ravotus/FaucetLED/README.md

# Faucet LED #
This project has a simple goal: To add a LED to a faucet which changes with temperature.

For the associated PCB, see [https://github.com/ravotus/FaucetLED-pcb](https://github.com/ravotus/FaucetLED-pcb)
