ravotus/FaucetLED/hardware/hardware.txt

LEDs
====
If 3.2V is not right enough on Green/Blue, could either remove series resistors, or go to up to 3.4 or 3.5V supply for micro (3.6V is max)

assume 3.3V supply:
Red: needs >=70 ohm (use 47+33=80)
Green/Blue: Needs >=5 ohm (10ohm in || )

From testing:
Rred = 78ohm (10+68), Ired = 18.49mA (78.7 is a standard value)
Rgreen = 10ohm, Igreen = 19.70mA
Rblue = 22ohm, Iblue = 19.64mA

Rred = 78ohm (10+68), Ired = 18.49mA
Rgreen = 12.2ohm (15||68), Igreen = 18.28mA
Rblue = 25ohm (15+10), Iblue = 18.60mA

Pin notes
=========
If you want to use a WKUP pin, must use WKUP4. In that case, cannot use LPUART.
On Nucleo board, VCP is connected to PA2 and PA15 (USART2).
If you want to power directly from 3.3V, need to remove some SB's

Clocks
======
MSI is much more power friendly than HSI48, also starts up faster (190uA vs 380uA) - although stabilization time is longer
HSI16 is very similar to MSI for current - both 190uA. Stabilization is much better though.

ADC
===
Be sure to calibrate ADC on powerup. Software can save the calibration value and restore it each time.
Is being very picky - seems to always be one conversion short in interrupt or polling mode, unless I slow the ADC way down (/128 clk).
Per datasheet, Vrefint needs a sampele time of 4us minimum.
If using oversampling on both regular and injected channels, the oversampling ratio must be the same! (or reconfigured before starting each conversion)

Piezo amplifier circuit
=======================
Bias at Vcc/2 to avoid issues with differential signal.
Need to drive into ~10kohm load
Supply current to TLV2772: ~1.5mA
Current to MAX4257: ~1.0mA

Choose MAX4256 (has SHDN input)

Temperature sensor
==================
Configure UART Tx/Rx pin as Open-Drain, with no internal pull up/down. The internal pullup is not strong enough.
Use an external 4.7kohm pullup.

CRC:
Both input and output needs to be configured to reverse bits, byte-wise. Use Dallas 1-wire CRC polynomial 0x31.

Power input
===========
Removed SB9 from Nucleo board and replaced with jumper. With jumper off, can power Nucleo from 5VIN but with any voltage
less than 5.5V. Micro ran fine even down to 2.5V, but below about 2.7V the blue LED didn't work (as expected). VIN is not
a feasible option due to the high dropout of the 5V regulator on that input. And obviously the 3.3V input is not an option
without an external regulator.

Low-power mode
==============
FreeRTOS running normally: 15mA
FreeRTOS tickless idle: 4.57mA
FreeRTOS tickless idle in LP sleep 10ms task MSI clk 400kHz: 707.95uA
To check for regressions with low-power tickless idle:
1. Configure one task to run every 10ms.
2. In PreSleepProcessing() inside freertos.c, set a GPIO right before calling HAL_PWR_EnterSLEEPMode, and clear it afterwards.
3. You should see the GPIO high (sleeping) approximately 80% of the time, and the signal having a period of around 10ms.
   You should not see the signal go high and low immediately, which indicates that the micro woke up instantly.
