ravotus/FaucetLED/resources/The Principles of Piezoelectric Accelerometers _ Sensors.pdf

12/10/2016 | The Principles of Piezoelectric Accelerometers | Sensors
file:///C:/Projects/FaucetLED/resources/The%20Principles%20of%20Piezoelectric%20Accelerometers%20_%20Sensors.html | 1/8

# Acceleration/Vibration

## Most Read Articles

Home (http://www.sensorsmag.com/?sessionGUID=0908801d-67c7-ac48-233a-68e95b3e403c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) > Sensors Products (http://www.sensorsmag.com/category/sensor/sensors-products?sessionGUID=0908801d-67c7-ac48-233a-68e95b3e403c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) > Acceleration/Vibration (http://www.sensorsmag.com/category/sensor/sensors-products/accelerationvibration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)
Related topics: Acceleration/Vibration, (http://www.sensorsmag.com/category/sensor/sensors-products/accelerationvibration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)Sensors Mag, (http://www.sensorsmag.com/category/sensor/sensors-mag?sessionGUID=0908801d-67c7-ac48-233a-68e95b3e403c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) Technologies in Depth, (http://www.sensorsmag.com/category/magazine-catchall/technologies-depth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) Technology Tutorials (http://www.sensorsmag.com/category/magazine-catchall/technology-tutorials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)

# The Principles of Piezoelectric Accelerometers

February 1, 2004
By: Guy Kulwanoski, (http://www.sensorsmag.com/sensors-author/guy-kulwanoski?sessionGUID=0908801d-67c7-ac48-233a-68e95b3e403c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) Kistler Instrument Corp., Jeff Schnellinger, (http://www.sensorsmag.com/sensors-author/jeff-schnellinger?sessionGUID=0908801d-67c7-ac48-233a-68e95b3e403c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) Kistler Instrument Corp.
Like 24 people like this.

The piezoelectric effect, discovered in 1880 by Pierre and Jacques Curie, remained a mere curiosity until the 1940s. The property of certain crystals to exhibit electrical charges under mechanical loading was of no practical use until very high input impedance amplifiers enabled engineers to amplify the signals produced by these crystals. In the 1950s, electrometer tubes of sufficient quality became available and the piezoelectric effect was commercialized.

Most piezoelectric accelerometers are made of quartz crystal, piezoelectric ceramics, or, for hightemperature operation, tourmaline or lithium niobate. They obey Newton's second law, F = ma, in that the force acting on the measuring element is directly proportional to the acceleration produced. Available in a wide range of configurations and operating specifications, these devices are used wherever shock or vibration is of interest.

The charge amplifier principle was patented by W.P. Kistler in 1950 and gained practical significance in the 1960s. The introduction of MOSFET solidstate circuitry and the development of highly insulating materials such as Teflon and Kapton greatly improved performance and propelled the use of piezoelectric sensors into virtually all areas of modern technology and industry.

Email Newsletters (http://www.sensorsmag.com/sensors-newsletter-subscription?sessionGUID=0908801d-67c7-ac48-233a-68e95b3e403c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)

White Paper Library (http://www.sensorsmag.com/white-paper-library?sessionGUID=0908801d-67c7-ac48-233a-68e95b3e403c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)

Sensors Job Board (http://jobs.sensorsmag.com/)

A Dozen Ways to Measure Fluid Level and How They Work (http://www.sensorsmag.com/sensors/leak-level/a-dozen-ways-measure-fluid-level-and-how-they-work-1067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)

Fundamentals of Pressure Sensor Technology (http://www.sensorsmag.com/sensors/pressure/fundamentals-pressure-sensor-technology-846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)

Manometer Basics (http://www.sensorsmag.com/sensors/pressure/manometer-basics-1073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)

The Basics of Rotameters (http://www.sensorsmag.com/sensors/flow/the-basics-rotameters-1068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)

The Principles of Level
Measurement (http://www.sensorsmag.com/sensors/leak-level/the-principles-level-measurement-941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)

## Editor’s Picks

ARTICLE
A Testbed for Building Intuitive and Scalable IoT Apps (http://www.sensorsmag.com/internet-things/testbed-building-intuitive-and-scalable-iot-apps-24087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)

NEWS
High Pressure Seals Market Worth 6.99 Billion USD by
2026 (http://www.sensorsmag.com/news/market-news/news/high-pressure-seals-market-worth-699-billion-usd-2026-24095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)

NEWS
Smart Material Market
Estimated to Generate $72.63 Billion by 2022 (http://www.sensorsmag.com/news/market-news/news/smart-material-market-estimated-generate-7263-billion-2022-24096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)

NEWS
Service Robotics Market Worth (http://www.sensorsmag.com/news/market-news/news/service-robotics-market-worth-us-13-billion-2021-24075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)
Electronics & Computers (http://www.sensorsmag.com/electronics-computers?sessionGUID=0908801d-67c7-ac48-233a-68e95b3e403c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) | Embedded Systems (http://www.sensorsmag.com/electronics-computers/embedded-systems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) | Internet of Things (http://www.sensorsmag.com/networking-communications/internet-of-things-0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) | Machine Manufacturing (http://www.sensorsmag.com/machine-manufacturing?sessionGUID=0908801d-67c7-ac48-233a-68e95b3e403c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) | Process Industries (http://www.sensorsmag.com/process-industries?sessionGUID=0908801d-67c7-ac48-233a-68e95b3e403c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) | Specialty Markets (http://www.sensorsmag.com/specialty-markets?sessionGUID=0908801d-67c7-ac48-233a-68e95b3e403c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) | Wireless & M2M (http://www.sensorsmag.com/networking-communications?sessionGUID=0908801d-67c7-ac48-233a-68e95b3e403c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)
Home (http://www.sensorsmag.com/?sessionGUID=0908801d-67c7-ac48-233a-68e95b3e403c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) | News (http://www.sensorsmag.com/listing/94/news-room?sessionGUID=0908801d-67c7-ac48-233a-68e95b3e403c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) | Resource Center (http://www.sensorsmag.com/?sessionGUID=0908801d-67c7-ac48-233a-68e95b3e403c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) | Technical Articles (http://www.sensorsmag.com/technical-articles?sessionGUID=0908801d-67c7-ac48-233a-68e95b3e403c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) | About Sensors (http://www.sensorsmag.com/about-sensors?sessionGUID=0908801d-67c7-ac48-233a-68e95b3e403c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) | Advertise (http://www.sensorsmag.com/advertise?sessionGUID=0908801d-67c7-ac48-233a-68e95b3e403c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) | Browse by Topic (http://www.sensorsmag.com/browse-by-topic?sessionGUID=0908801d-67c7-ac48-233a-68e95b3e403c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) | Sensors Expo (http://www.sensorsmag.com/sensorsexpo?sessionGUID=0908801d-67c7-ac48-233a-68e95b3e403c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)

file:///C:/Projects/FaucetLED/resources/The%20Principles%20of%20Piezoelectric%20Accelerometers%20_%20Sensors.html | 2/8

Figure 1. Piezoelectric crystals that are cut so that they exhibit the longitudinal effect (A) are sensitive to compression forces. They are used primarily to measure force, pressure, strain, and acceleration. The transverse effect (B) makes it possible to obtain a greater charge by suitable shaping and arrangement of the piezoelectric elements, and is used primarily in pressure sensors. Shear effect elements
(C) are chiefly used in accelerometers and 3-component force sensors. They have low basestrain sensitivity (the amount of strains in an object under test that are transmitted via the base plate to the sensor element) and a (https://www.facebook.com/SensorsMagazine) wellb (https://twitter.com/sensorsonline)ehav (http://www.linkedin.com/groups/Sensors-Magazine-4568519?trk=myg_ugrp_ovr)ed (http://www.sensorsmag.com/rss-subscription?sessionGUID=0908801d-67c7-ac48-233a-68e95b3e403c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) response to rapid temperatu (https://www.facebook.com/SensorsMagazine)re c (https://twitter.com/sensorsonline)hang (http://www.linkedin.com/groups/Sensors-Magazine-4568519?trk=myg_ugrp_ovr)es (http://www.sensorsmag.com/rss-subscription?sessionGUID=0908801d-67c7-ac48-233a-68e95b3e403c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) because these influences act in a direction perpendicular to the sensitive shear axis.

Piezoelectric measuring systems are active electrical systems. That is, the crystals produce an electrical output only when they experience a change in load?they cannot perform true static measurements. However, it is a misconception that piezoelectric iýstruments are suitable for only dynamic measurements. Quartz transducers, when paired with adequate signal conditioners, offer excellent quasistatic measuring capability. There are countless examples of applications where quartzbased sensors accurately and reliably measure quasistatic phenomena for minutes and even hours.

There are two types of piezoelectric sensor: high and low impedance. Highimpedance units have a charge output that requires a charge amplifier or external impedance converter for chargetovoltage conversion. Lowimpedance types use the same piezoelectric sensing element as highimpedance units and also incorporate a miniaturized builtin chargetovoltage converter. They also require an external power supply coupler to energize the electronics and decouple the subsequent DC bias voltage from the output signal.

Quartz-Based Piezoelectric Sensors

Although this article focuses on accelerometers, the response function for force and pressure sensors is nearly identical. In fact,

many force applications are closely related to acceleration. On the other
hand, pressure sensors are designed to minimize or eliminate (by direct
compensation of the charge output) the vibration effect.

Quartz piezoelectric sensors consist essentially of thin slabs or plates cut in a precise orientation to the crystal axes depending on the application (see Figure 1, and "The Piezoelectric Effect in Crystals"). (http://www.sensorsmag.com/sensors/acceleration-vibration/the-principles-piezoelectric-accelerometers-1022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) Most Kistler sensors incorporate a quartz element that is sensitive to either compressive or shear loads. The shear cut is used for multicomponent force and acceleration measuring sensors. Other specialized cuts include the transverse cut for some pressure sensors and the polystable cut for hightemperature pressure sensors.

The finely lapped quartz elements are assembled either singly or in stacks and preloaded in some manner. The quartz package generates a charge signal, measured in picoCoulombs, that is directly proportional to the sustained force. Each sensor type uses a quartz configuration optimized and ultimately calibrated for its particular application (e.g., force, pressure, acceleration, or strain).

Of the large number of piezoelectric materials available today, quartz is preferred in sensor designs because of the following properties:

Material stress limit of ~20,000 psi
Temperature resistance up to 930°F
Very high rigidity, high linearity, and negligible hysteresis Almost constant sensitivity over a wide temperature range Ultrahigh insulation resistance (1014 ), allowing lowfrequency measurements (<1 Hz)

Dynamic Behavior

Piezoelectric sensors for measuring pressure, force, and acceleration may
be regarded as underdamped, spring mass systems with a single degree
of freedom. They are modeled by the classical secondorder differential equation whose solution is:

(1)

where:
fn = undamped natural (resonant) frequency (Hz)
f = frequency at any given point of the curve (Hz) ao = output acceleration
ab = mounting base or reference acceleration (f/fn = 1)
Q = factor of amplitude increase at resonance

Quartz sensors have a Q of ~10?40; the phase angle can therefore be written as:

(2)

US$ 13 Billion by 2021 (http://www.sensorsmag.com/news/market-news/news/service-robotics-market-worth-us-13-billion-2021-24075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)

NEWS
Color Microscope Camera
Provides Intelligent Real-Time and Fluorescence Imaging (http://www.sensorsmag.com/sensors-products/machine-vision/news/color-microscope-camera-provides-intelligent-real-time-and-24081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)
Log in (https://googleads.g.doubleclick.net/pcs/click?sig=Cg0ArKJSzJTVI3IMU-1c) | Sea | Print | Email rch

file:///C:/Projects/FaucetLED/resources/The%20Principles%20of%20Piezoelectric%20Accelerometers%20_%20Sensors.html | 3/8

As can be seen in a typical frequency response curve (see Figure 2), an amplitude rise of ~5% can be expected at ~

1
/5 of fn

Figure 2. In this typical response curve, 1 = lowfrequency limit determined by RC rolloff characteristics; 2 = usable range; 3 = highpass filter; and 4 = with lowpass filter, which can be used to attenuate the effects of the amplitude rise at ~1/5 the resonance frequency.

Lowpass filtering can be used to attenuate the effects of this. Many Kistler signal conditioners (charge amplifiers and couplers) have plugin filters for this purpose.

Charge Amplifiers

Basically the charge amplifier consists of a highgain inverting voltage amplifier with a MOSFET or JFET at its input to achieve high insulation resistance (see Figure 3).

Figure 3. The charge amplifier consists of a highgain inverting voltage amplifier with a FET at its input for high insulation resistance. In this simplified schematic, 1 = accelerometer; 2 = charge amplifier; Vo = output voltage; A = openloop gain; Ct = sensor capacitance; Cc = cable capacitance; Cr = range (or feedback) capacitor; Rt = time constant resistor (or insulation resistance of range capacitor); Ri = insulation resistance of input circuit (cable and sensor); and q = charge generated by sensor.

The effects of Rt and Ri will be discussed below. Neglecting their effects, the resulting output voltage, Vo

, becomes:

(3)

where:

Log in (http://www.sensorsmag.com/sensors-magazine-media-kit-request?sessionGUID=0908801d-67c7-ac48-233a-68e95b3e403c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) | Sea | Print | Email rch

file:///C:/Projects/FaucetLED/resources/The%20Principles%20of%20Piezoelectric%20Accelerometers%20_%20Sensors.html | 4/8

q = charge generated by the sensor Cr = range capacitor
Ct = sensor capacitance
Cc = cable capacitance
A = openloop gain

For sufficiently high openloop gain, the cable and sensor capacitance can be neglected, leaving the output voltage dependent only on the input charge and the range capacitance:

(4)

In short, the amplifier acts as a charge integrator that compensates the sensor's electrical charge with a charge of equal magnitude and opposite polarity, and ultimately produces a voltage across the range capacitor. In effect, the purpose of the charge amplifier is to convert the high impedance charge input, q, into a usable output voltage, Vo

Time Constant and Drift. Two of the more important considerations in the practical use of charge amplifiers are time constant and drift. The time constant (TC) is defined as the discharge time of an AC-coupled circuit. In a period of time equivalent to one time constant, a step input will decay to 37% of its original value. The TC of a charge amplifier is determined by the product of the range capacitor, Cr

, and the time constant resistor, Rt

:

(5)

Drift is defined as an undesirable change in output signal over time that is not a function of the measured variable. Drift in a charge amplifier can be caused by low insulation resistance at the input, Ri

, or by leakage current of the input MOSFET or JFET. Drift and time constant simultaneously affect a charge amplifier's output. One or the other will be dominant. Either the charge amplifier output will drift toward saturation (power supply) at the drift rate, or it will decay toward zero at the time constant rate.

Many Kistler charge amplifiers have selectable time constants that are altered by changing the time constant resistor Rt

. Several
of these charge amplifiers have a short, medium, or long time constant selection switch. In the long position, drift dominates any time constant effect. As long as the input insulation resistance Ri

is maintained at >10

13
, the charge amplifier (with MOSFET input) will drift at an approximate rate of 0.03 pC/s. Charge amplifiers with JFET inputs are available for industrial applications but have an increased drift rate of ~0.3 pC/s. In the short and medium positions, t°e time constant effect dominates normal leakage drift. The actual value can be determined by referring to the appropriate operation/instruction manual supplied with the unit.

Frequency and Time Domain Considerations. When considering the effects of time constant, the user must think in terms of either frequency or time domain. The longer the time constant, the better the lowend frequency response and the longer the usable measuring time. When measuring vibration, time constant has the same effect as a singlepole, highpass filter whose amplitude and phase are:

(6)

(7)

For example, the output voltage has declined ~5% when f × (TC) = 0.5 and the phase lead = 18°. When measuring events with wide (or multiple) pulse widths, the time constant should be at least 100 × longer than the total event duration. Otherwise, the DC component of the output signal will decay toward zero before the event is completed.

Other design features incorporated into Kistler charge amplifiers include range normalization for whole number output, lowpass filters for attenuating sensor resonant effects, electrical isolation for minimizing ground loops, and digital/computer control of setup parameters.

Low-Impedance Piezoelectric Sensors

Piezoelectric sensors with miniature, builtin chargetovoltage converters are identified as lowimpedance units for our purposes here. These units incorporate the same types of piezoelectric sensing element(s) as their highimpedance counterparts.

In 1966, Kistler developed the first commercially available piezoelectric sensor with internal circuitry. This circuit, of a patented design called the Piezotron, incorporates a miniature MOSFET input stage followed by a bipolar transistor stage and operates as a source follower (unity gain). These elements are incorporated in a monolithic IC. The circuit has an input impedance of

Log in (http://www.sensorsmag.com/content/login?destination=node%2F1022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) | Sea | Print | Email rch

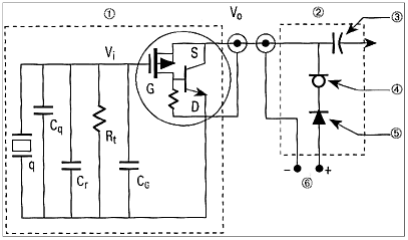
[picture p1: figure]

file:///C:/Projects/FaucetLED/resources/The%20Principles%20of%20Piezoelectric%20Accelerometers%20_%20Sensors.html | 5/8

10

14 | and output impedance of 100 | , which allows the charge generated by the quartz element to be converted into a
usable voltage. The Piezotron design requires only a single coax for powerin and signalout. Power to the circuit is provided by a coupler that supplies a 2?18 mA source current and a 20?30 VDC energizing voltage (see Figure 4).

Figure 4. All that is needed to operate a Kistler lowimpedance accelerometer are a coupler and coax cable. Here, 1 = accelerometer; 2 = coupler, 3 = decoupling capacitor; 4 = constantcurrent diode; 5 = reverse polarity protection diode; q = charge generated by piezoelectric element; Vi = input signal at gate; Vo = output voltage (usually bias decoupled); Cq = sensor capacitance; Cr = range capacitance; CG = MOSFET gate capacitance; and Rt = time constant resistor.

The steadystate output voltage is essentially the input voltage at the MOSFET gate plus any offset bias adjustment. The Piezotron's voltage sensitivity can be approximated by:

(8)

The range capacitance, Cr

, and time constant resistor, Rt

, are designed to provide a predetermined sensitivity (mV/g) and upper and lower usable frequencies. The exact sensitivity is measured during calibration and its value is recorded on each unit's calibration certificate.

Time Constant. The time constant of a Piezotron or similar quartz accelerometer is:

(9)

Time constant effects are the same in lowimpedance sensors and charge amplifiers. That is, both act as a singlepole, highpass filter as discussed previously.

Low-Impedance Power Supply

For excitation of their integral electronics, lowimpedance accelerometers require only a single coaxial cable and a power supply coupler. Both the power into and the signal out of the sensor are transmitted over this cable. The coupler provides the constant current excitation required for linear operation over a wide voltage range and also decouples the bias voltage from the output.

Time Constant. Bias decoupling methods can be categorized as AC or DC. DC decoupling will not affect a lowimpedance sensor's time constant and therefore permit optimum lowfrequency response. An offset voltage adjust is used to "zero" the bias. AC decoupling methods, however, can shorten the lowimpedance sensor's time constant and degrade lowfrequency response. In lowimpedance systems with AC bias decoupling, the system time constant can be approximated by taking the product of the sensor and coupler time constants and dividing by their sum. The resulting frequency response can be computed as before.

Comparing High and Low-Impedance Systems

Similarities.ðBoth use the same type of piezoelectric sensing element(s) and are therefore AC-coupled systems with limited lowfrequency response or quasistatic measuring capability. Their respective time constants determine the usable frequency range.

High Impedance. These are typically more versatile than lowimpedance systems. Time constant, gain, normalization, and reset are all controlled by means of an external charge amplifier. In addition, highimpedance systems usually have longer time constants that allow easy shortterm static calibration. With no builtin electronics, they have a wider operating temperature range.

Log in (http://www.sensorsmag.com/content/login?destination=node%2F1022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) | Sea | Print | Email rch

file:///C:/Projects/FaucetLED/resources/The%20Principles%20of%20Piezoelectric%20Accelerometers%20_%20Sensors.html | 6/8

Low Impedance. In general, lowimpedance systems are tailored to a particular application. Since these sensors have an internally fixed range and time constant, their use might be limited to a particular application. There is no such restriction on highimpedance systems, where range and time constant are controlled with an external charge amplifier. For applications with welldefined measuring frequency and temperature ranges, however, lowimpedance systems can cost less and furthermore can be used with generalpurpose cables in environments where high humidity and/or contamination could be detrimental to the high insulation resistance required for highimpedance sensors. Also, longer cable lengths between sensor and signal conditioner and compatibility with a wide range of signal display devices are further advantages of lowimpedance sensors.

An alternative method for processing charge from highimpedance sensors is to use an external impedance converter, which exploits the high temperature range of the sensor while offering the convenience and costeffectiveness of a coupler, as compared to a charge amp.

Applications of Piezoelectric Accelerometers

Piezoelectric measuring devices are widely used today in the laboratory, on the production floor, and as original equipment for measuring and recording dynamic changes in mechanical variables including shock and vibration. The following is only a partial list:

Aerospace. Modal testing, wind tunnel, and shock tube instrumentation; landing gear hydraulics; rocketry; structures; ejection systems
Ballistics. Combustion, explosion, and detonation
Engine Testing. Combustion and dynamic stressing
Engineering. Materials evaluation, control systems, reactors, structural analysis, auto chassis structural testing, shock and vibration isolation, and dynamic response testing
Industrial/Factory. Machining systems, metal cutting, and machine health monitoring
OEMs. Transportation systems, rockets, machine tools, engines, flexible structures, and shock/vibration testers

The Piezoelectric Effect in Crystals
In 1880, brothers Pierre and Jacques Curie demonstrated the relationship between a mechanical load on a crystal (they worked with tourmaline, quartz, and Rochelle salt) and the electric charge resulting from it. Piezoelectricity is a linear electromechanical interaction between the mechanical and electrical states of crystals with no symmetric centers. The crystals can have one or more polar axes along which the effect occurs.

The piezoelectric effect results from a deformation of the crystal lattice by some external force that pushes the positive and negative lattice points against one another and thus produces a dipole moment. Depending on the orientation of the axes with respect to the applied force, three different types of effect can be discerned (see Figure 5).

Figure 5. The way the quartz crystal is sliced (see Figure 1) determines the behavior of the finished sensing element. The piezoelectric effect can take one of three forms: longitudinal (A), transverse (B),
or shear (C).

Longitudinal Effect. The size of the charge depends only on the force applied. The only way to increase this charge is to connect several plates mechanically in series and electrically in parallel. If this is done, the charge is:

Qx = d11 × Fx × n

where:

d11 = piezoelectric coefficient (for quartz crystal, d11 = ?2.30 pC/N)<

F = applied force

Log in (http://www.sensorsmag.com/content/login?destination=node%2F1022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) | Sea | Print | Email rch

file:///C:/Projects/FaucetLED/resources/The%20Principles%20of%20Piezoelectric%20Accelerometers%20_%20Sensors.html | 7/8
Bookmark it: | digg (http://digg.com/submit?phase=2&title=) | del.icio.us (http://delicious.com/post?title=) | technorati (http://technorati.com/faves) | yahoo (http://myweb2.search.yahoo.com/myresults/bookmarklet?t=) | facebook (http://www.facebook.com/sharer.php?t=) | twitter (http://www.twitter.com/home/)

Add Comment

n = number of crystal plates

x = direction of applied force

Shear Effect. This effect, too, is independent of the size and shape of the piezoelectric element as well as of the charge distribution. The charge occurs at the surfaces under load; at n elements connected mechanically in series and electrically in series is:

Qx = 2 × d11 × Fx × n

Transverse Effect. In this case, a force in the direction of one of the neutral axes produces a charge on the surfaces of the corresponding polar axis. The magnitude of the charge is dependent on the geometrical dimensions of the piezoelectric element. Assuming dimensions a, b, and c, the charge is:

Qy = ?d11 × Fy × b/a

where:

y = a neutral axis

This material, and the caption for Figure 1, were excerpted from Measuring with Crystals, Bernhard Bill, tr. Peter Wareham, 2002, Verlag Moderne Industrie.

Log in (http://www.sensorsmag.com/content/login?destination=node%2F1022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) | Sea | Print | Email rch (http://googleads.g.doubleclick.net/pcs/click?sig=Cg0ArKJSzIHu9ZitT_fT)

file:///C:/Projects/FaucetLED/resources/The%20Principles%20of%20Piezoelectric%20Accelerometers%20_%20Sensors.html | 8/8
Quick Links Twitter Feed | Find It Fix It Forum

31 Oct (https://twitter.com/sensorsonline/status/793159114247446529)

Latest News: Sensirion sensor + Fraunhofer micropump = A miniaturized smart drug delivery module: Fraunhofer ... bit.ly/2esfcSD (https://t.co/BCpWhVxXSd)

Automotive News: HARMAN and Airbiquity Announce the First Automotive Grade End-

Sensors Online
@sensorsonline

Sensors Online
@sensorsonline (https://twitter.com/sensorsonline)

Sensors invites you to join the Findit-Fixit Forum, where you can get answers to your (http://findit-fixit.sensorsmag.com/) sensing questions—concerning technologies, products, methods, applications, and services and also offer help to your fellow engineers. The Forum covers all kinds of topics, from the basics to the extraordinary.

Join the discussion! (http://findit-fixit.sensorsmag.com/)

## Home (http://www.sensorsmag.com/?sessionGUID=0908801d-67c7-ac48-233a-68e95b3e403c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)

Subscribe (http://www.sensorsmag.com/sensors-newsletter-subscription?sessionGUID=0908801d-67c7-ac48-233a-68e95b3e403c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)
News (http://www.sensorsmag.com/listing/94/news-room?sessionGUID=0908801d-67c7-ac48-233a-68e95b3e403c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)
Opinion (http://www.sensorsmag.com/opinion?sessionGUID=0908801d-67c7-ac48-233a-68e95b3e403c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)

## Technical

Articles (http://www.sensorsmag.com/technical-articles?sessionGUID=0908801d-67c7-ac48-233a-68e95b3e403c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)
About Sensors (http://www.sensorsmag.com/about-sensors?sessionGUID=0908801d-67c7-ac48-233a-68e95b3e403c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)

## Browse by

Topic (http://www.sensorsmag.com/browse-by-topic?sessionGUID=0908801d-67c7-ac48-233a-68e95b3e403c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) Advertise (http://www.sensorsmag.com/about-sensors?sessionGUID=0908801d-67c7-ac48-233a-68e95b3e403c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)

Media Kit (http://www.sensorsmag.com/sensors-magazine-media-kit-request?sessionGUID=0908801d-67c7-ac48-233a-68e95b3e403c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) Sensors Expo (http://www.sensorsmag.com/sensorsexpo?sessionGUID=0908801d-67c7-ac48-233a-68e95b3e403c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) Contributor/Advertiser Toolkit (http://www.sensorsmag.com/contributoradvertiser-toolkit?sessionGUID=0908801d-67c7-ac48-233a-68e95b3e403c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) | © Copyright 2016 Questex, LLC. (http://www.questex.com/) All Rights Reserved. Sensorsmag. Privacy Policy (http://www.questex.com/privacy-policy) | Terms of Use (http://www.questex.com/terms-use) | If you are having technical difficulties or considerations, please contact the webmaster. (http://www.sensorsmag.com/contact-webmaster?sessionGUID=0908801d-67c7-ac48-233a-68e95b3e403c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)
Log in (http://www.sensorsmag.com/browse-by-topic?sessionGUID=0908801d-67c7-ac48-233a-68e95b3e403c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) | Sea | Print | Email rch
