ravotus/FaucetLED/hardware/low-power/switched-thermistor.png

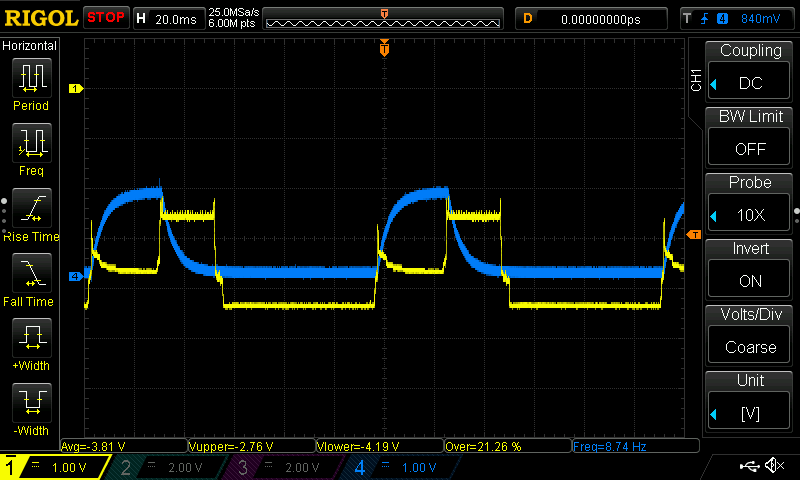
hardware/low-power/switched-thermistor.png
