ravotus/FaucetLED/hardware/MAX4257_10pF/bump-faucet.png

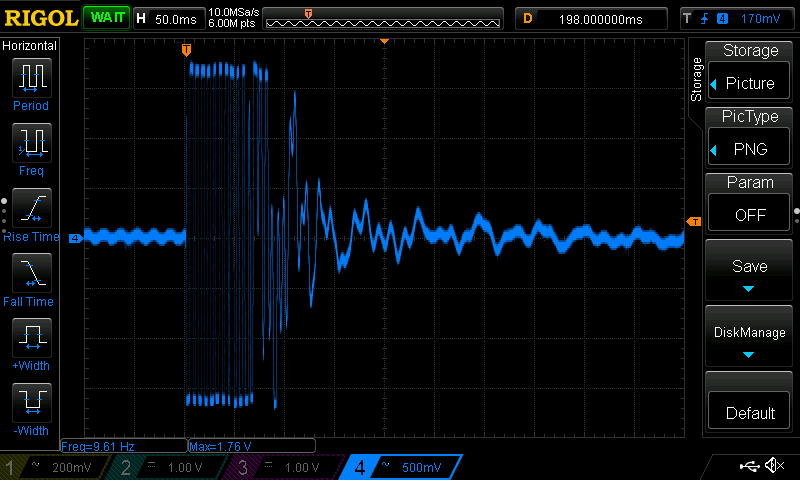
hardware/MAX4257_10pF/bump-faucet.png
