ravotus/FaucetLED/hardware/MAX4257_10pF/highpass/no-filter-off.png

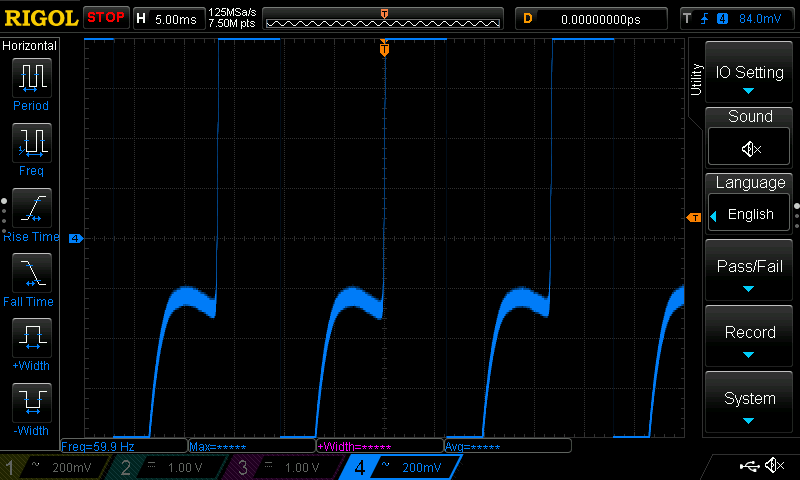
hardware/MAX4257_10pF/highpass/no-filter-off.png
