ravotus/FaucetLED/hardware/MAX4257_10pF/hit-counter.png

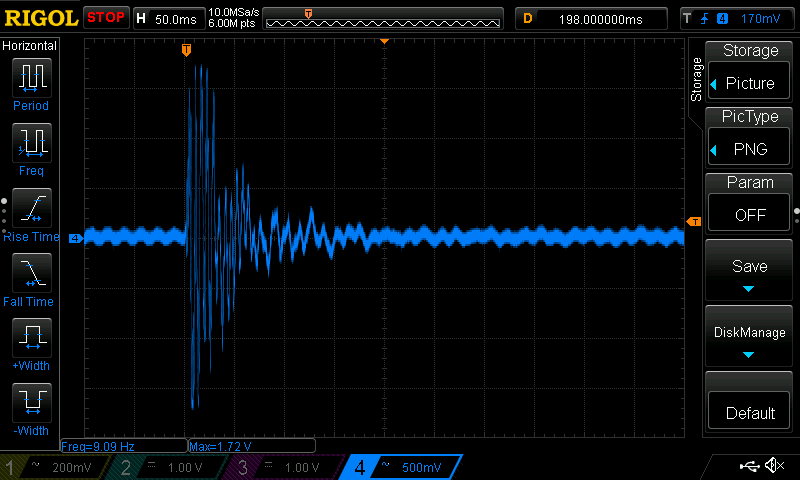
hardware/MAX4257_10pF/hit-counter.png
