ravotus/FaucetLED/hardware/MAX4257_10pF/shielded/shielded-off.png

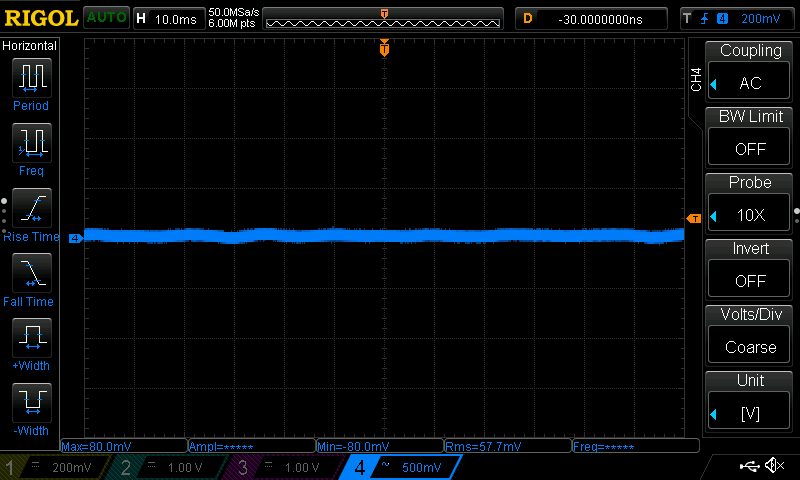
hardware/MAX4257_10pF/shielded/shielded-off.png
