ravotus/FaucetLED/hardware/MAX4257_10pF/shielded/shielded-running.png

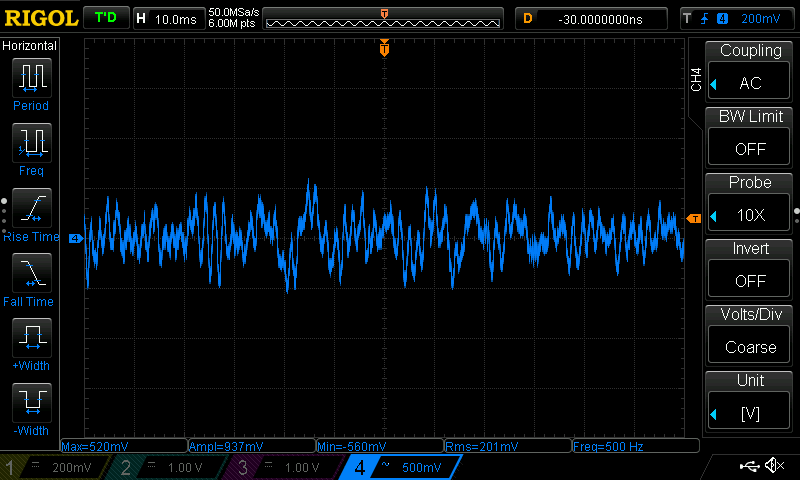
hardware/MAX4257_10pF/shielded/shielded-running.png
