ravotus/FaucetLED/hardware/MAX4257_10pF/shielded/unshielded-off.png

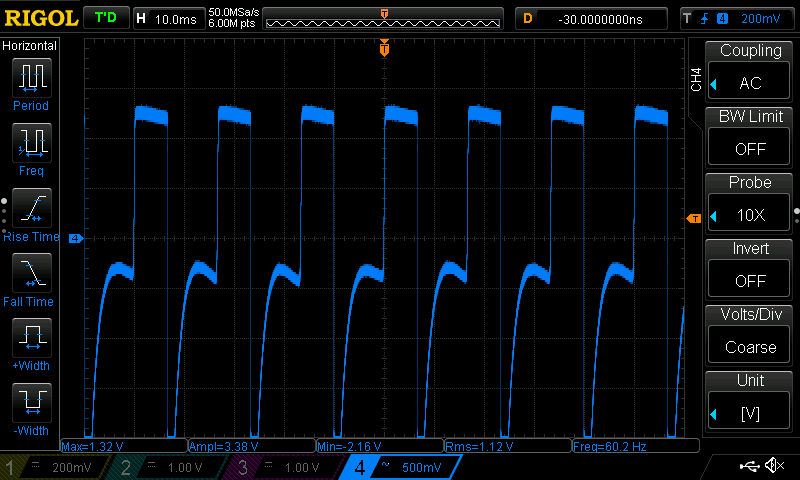
hardware/MAX4257_10pF/shielded/unshielded-off.png
