ravotus/FaucetLED/hardware/MAX4257_10pF/shielded/unshielded-running.png

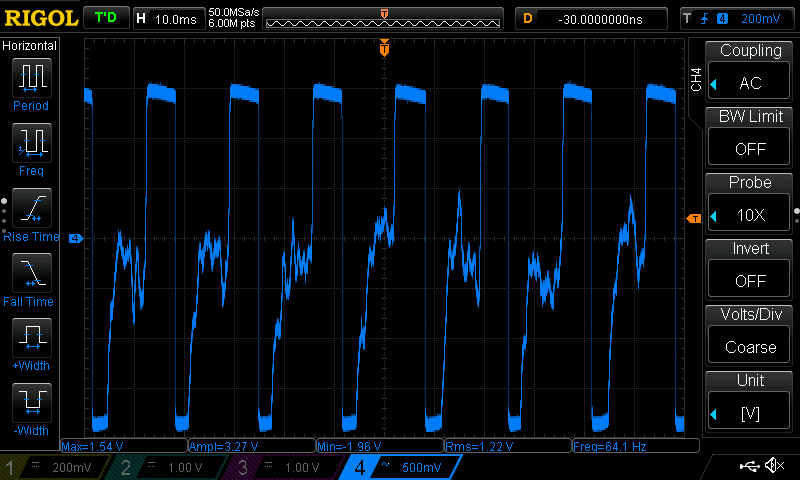
hardware/MAX4257_10pF/shielded/unshielded-running.png
