ravotus/FaucetLED/hardware/MAX4257_10pF/sink-turn-on.png

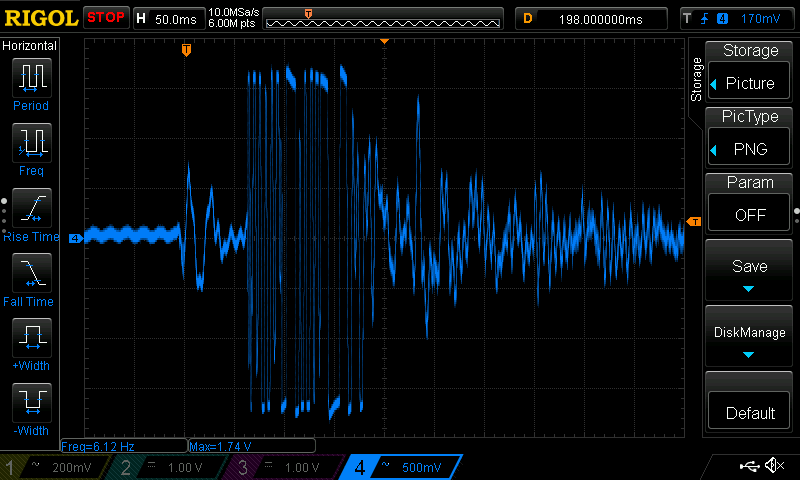
hardware/MAX4257_10pF/sink-turn-on.png
