ravotus/FaucetLED/hardware/MAX4257_10pF/water-off.png

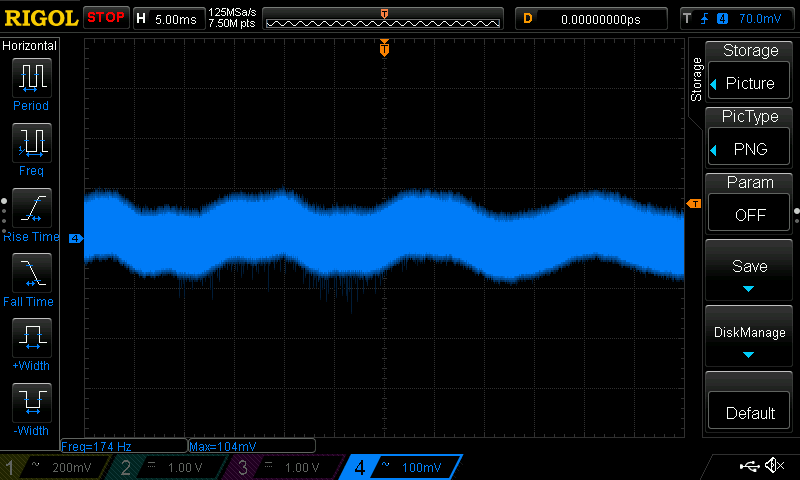
hardware/MAX4257_10pF/water-off.png
