ravotus/FaucetLED/hardware/MAX4257_10pF/water-running.png

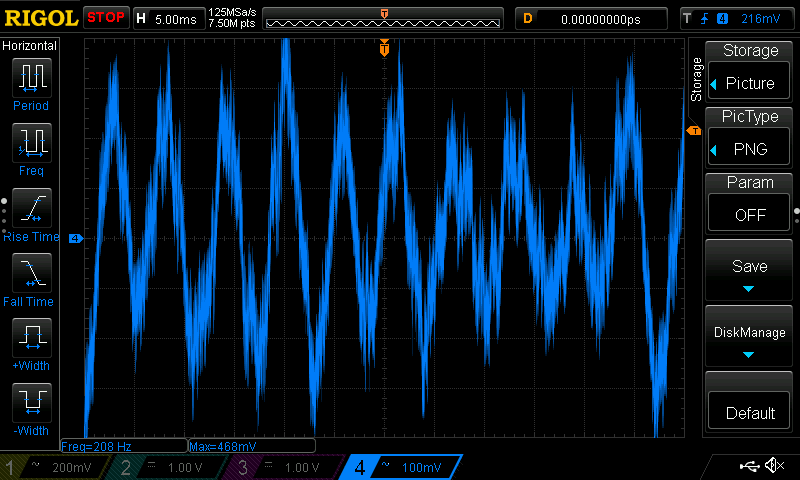
hardware/MAX4257_10pF/water-running.png
