ravotus/FaucetLED/hardware/MAX4257_100pF/turn-off.png

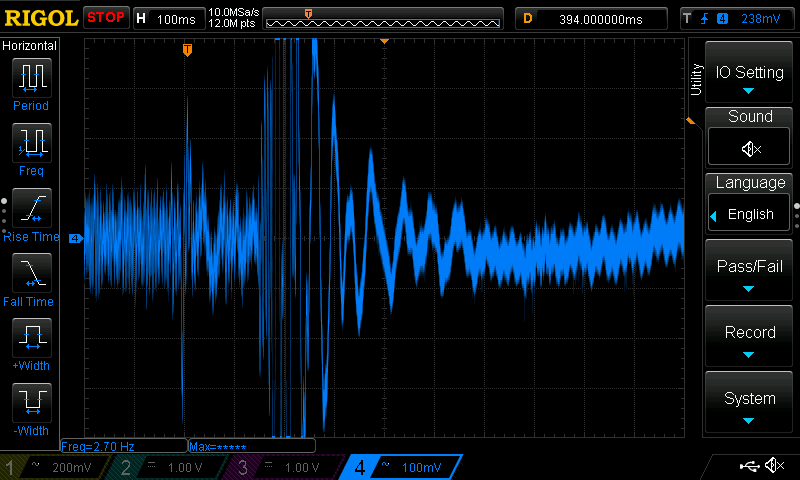
hardware/MAX4257_100pF/turn-off.png
