ravotus/FaucetLED/hardware/MAX4257_100pF/turn-on-1.png

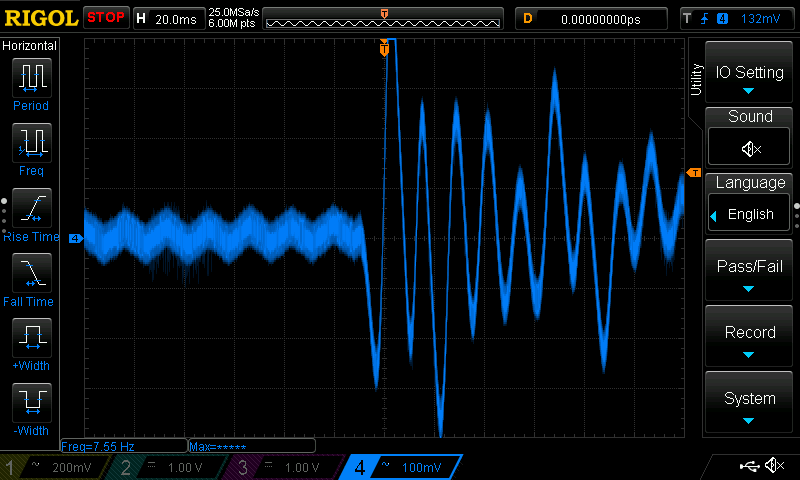
hardware/MAX4257_100pF/turn-on-1.png
