ravotus/FaucetLED/hardware/MAX4257_100pF/turn-on-2.png

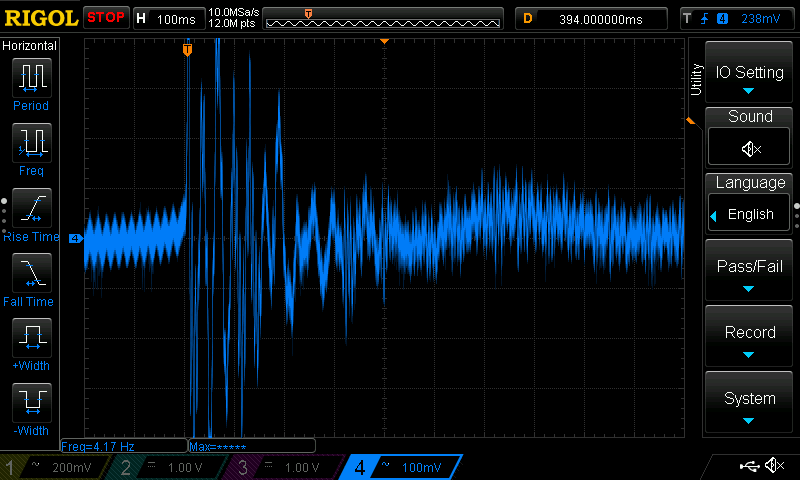
hardware/MAX4257_100pF/turn-on-2.png
