ravotus/FaucetLED/hardware/MAX4257_100pF/water-running.png

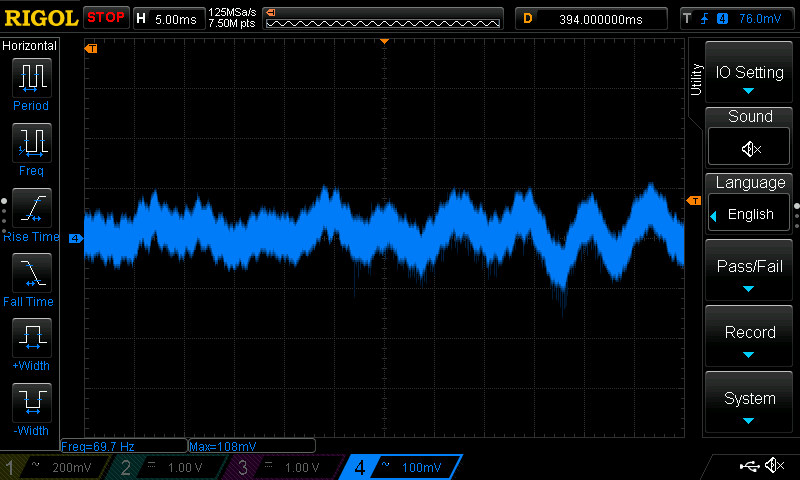
hardware/MAX4257_100pF/water-running.png
