ravotus/FaucetLED/hardware/STM32_OPAMP/HitSink.png

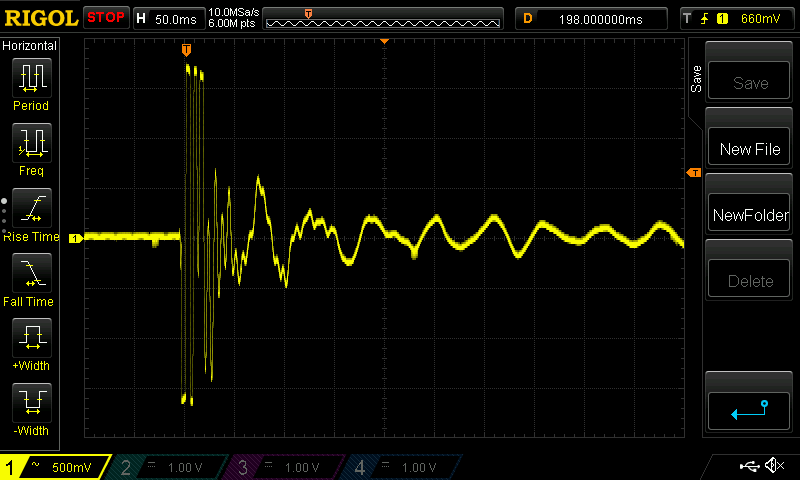
hardware/STM32_OPAMP/HitSink.png
