ravotus/FaucetLED/hardware/STM32_OPAMP/TurnOnSink.png

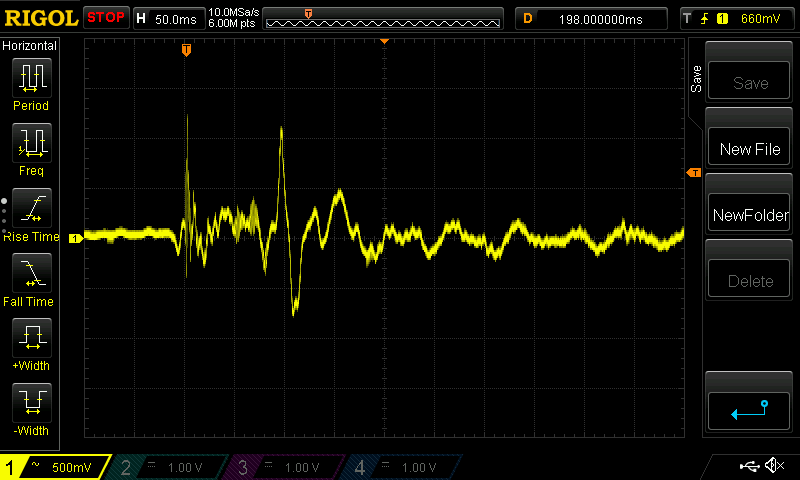
hardware/STM32_OPAMP/TurnOnSink.png
