ravotus/FaucetLED/hardware/STM32_OPAMP/WaterRunning.png

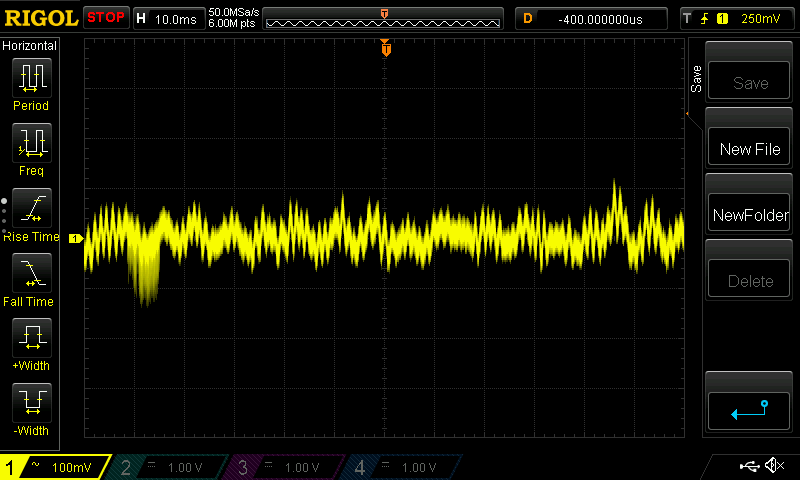
hardware/STM32_OPAMP/WaterRunning.png
