ravotus/FaucetLED/hardware/TLV2772/HitSink2.png

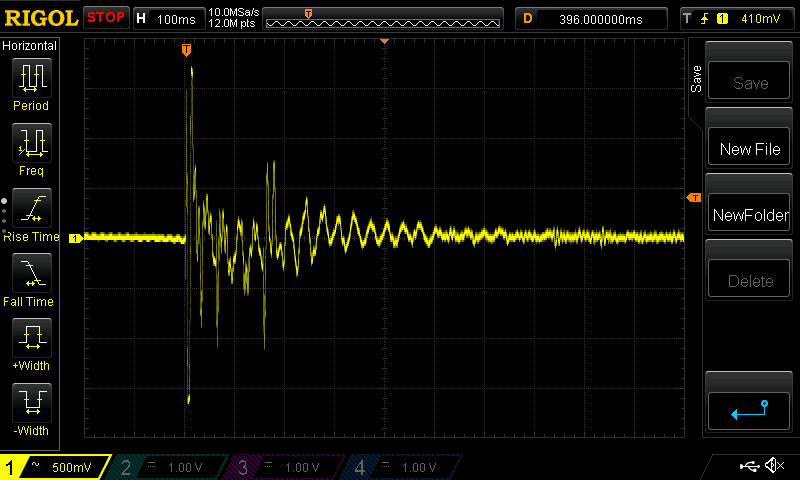
hardware/TLV2772/HitSink2.png
