ravotus/FaucetLED/hardware/TLV2772/HitSink.png

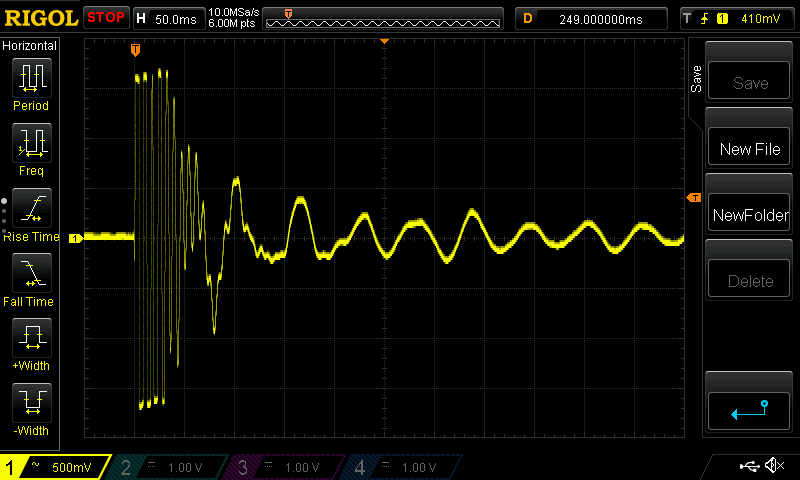
hardware/TLV2772/HitSink.png
