ravotus/FaucetLED/hardware/TLV2772/TurnOnSink.png

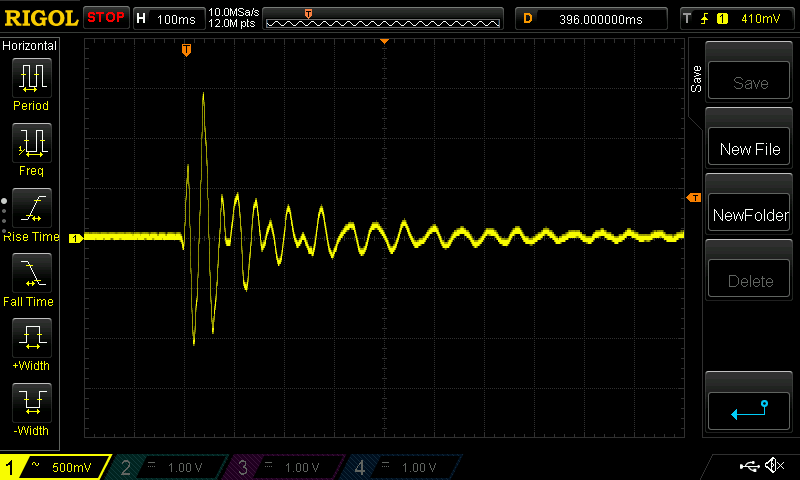
hardware/TLV2772/TurnOnSink.png
