ravotus/FaucetLED/hardware/TLV2772/WaterRunning.png

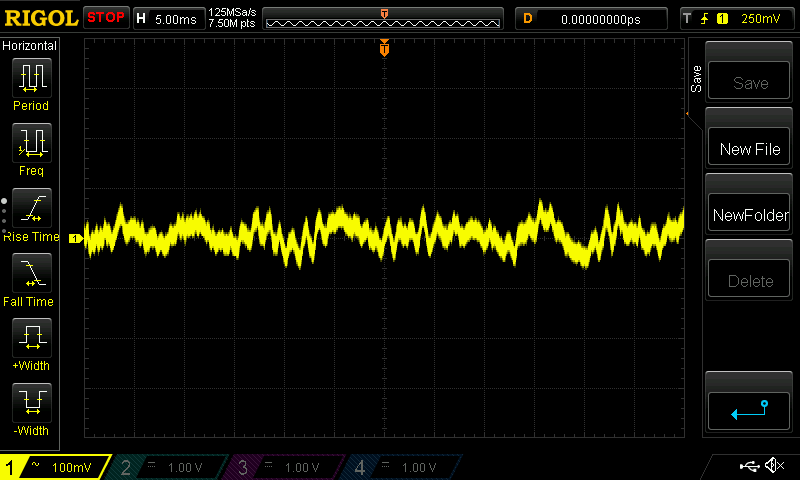
hardware/TLV2772/WaterRunning.png
