ravotus/FaucetLED/resources/582_circuit_1.jpg

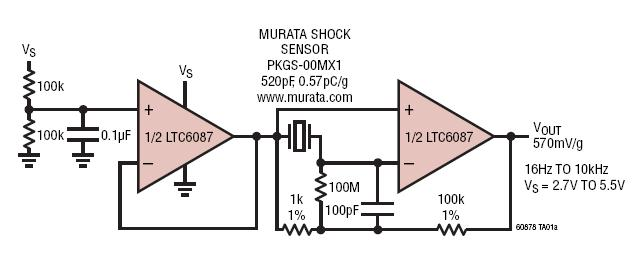
resources/582_circuit_1.jpg
