ravotus/FaucetLED/hardware/MAX4257_10pF/highpass/1st-order-off.png

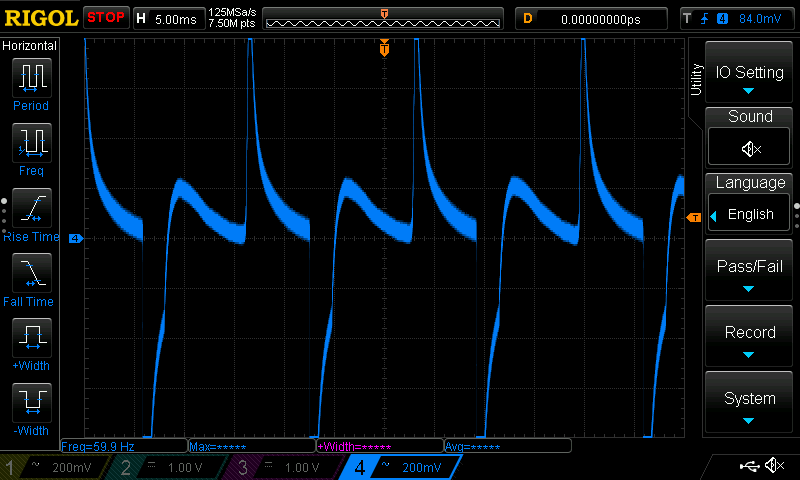
hardware/MAX4257_10pF/highpass/1st-order-off.png
