ravotus/FaucetLED/hardware/MAX4257_10pF/highpass/1st-order-running.png

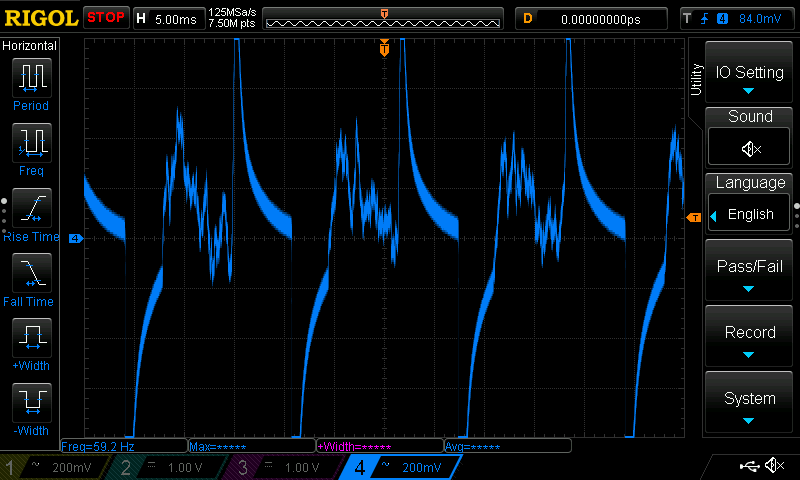
hardware/MAX4257_10pF/highpass/1st-order-running.png
