ravotus/FaucetLED/hardware/MAX4257_10pF/highpass/2nd-order-off.png

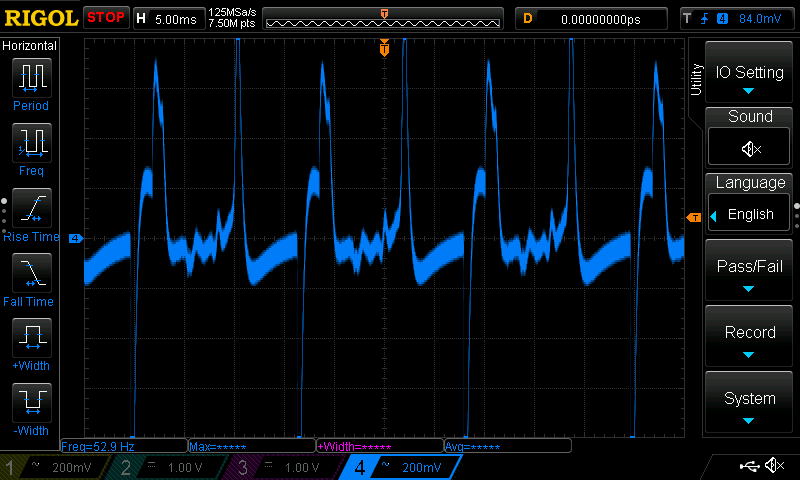
hardware/MAX4257_10pF/highpass/2nd-order-off.png
