ravotus/FaucetLED/hardware/MAX4257_10pF/highpass/2nd-order-running.png

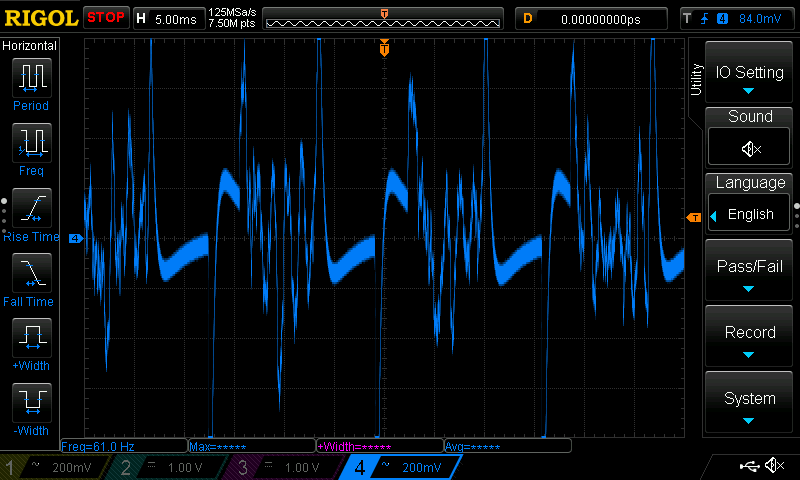
hardware/MAX4257_10pF/highpass/2nd-order-running.png
