ravotus/FaucetLED/hardware/MAX4257_10pF/FFT/DS1Z_QuickPrint6.png

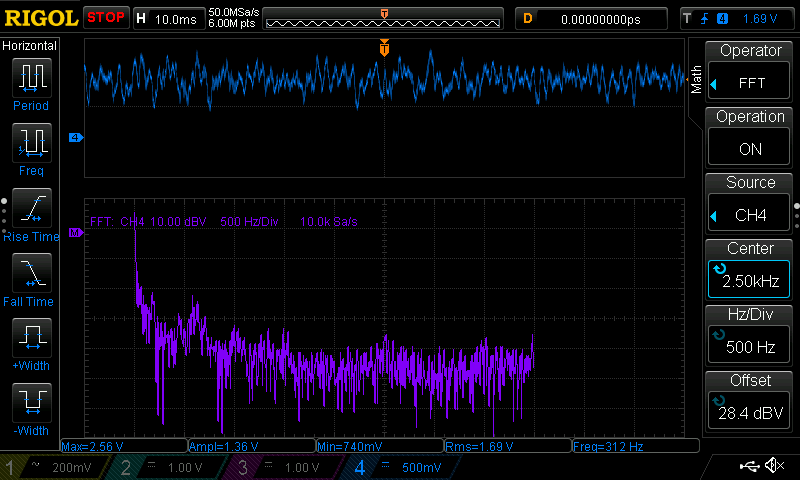
hardware/MAX4257_10pF/FFT/DS1Z_QuickPrint6.png
