ravotus/FaucetLED/hardware/MAX4257_10pF/FFT/DS1Z_QuickPrint10.png

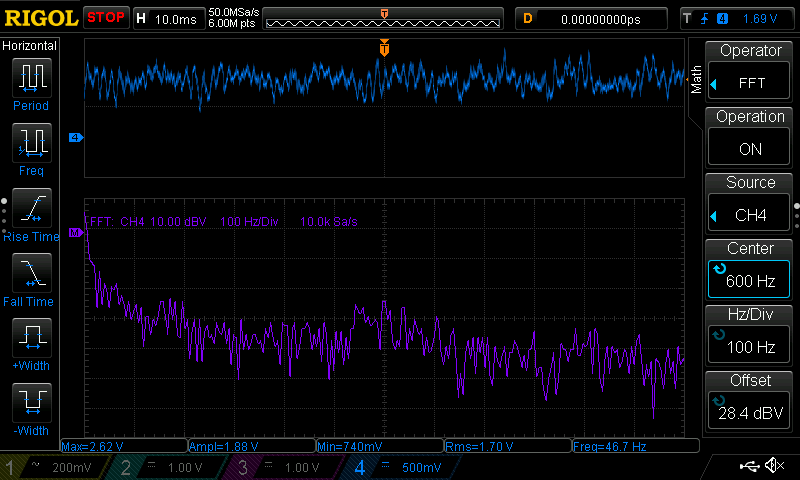
hardware/MAX4257_10pF/FFT/DS1Z_QuickPrint10.png
