ravotus/FaucetLED/hardware/MAX4257_10pF/FFT/DS1Z_QuickPrint13.png

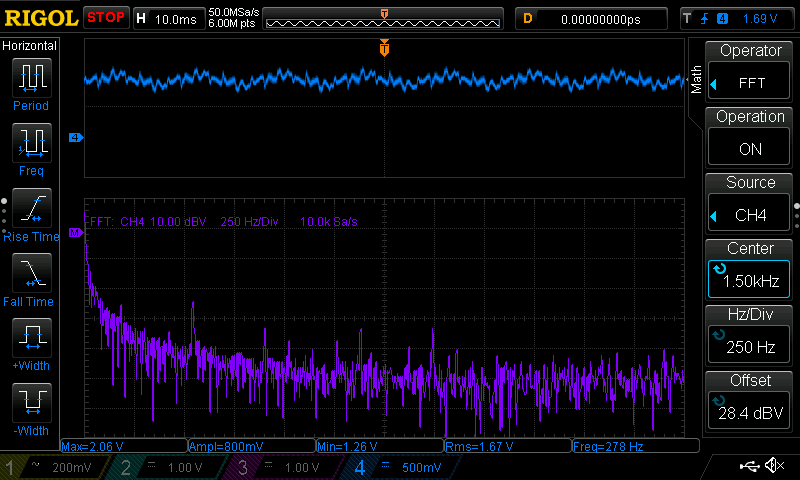
hardware/MAX4257_10pF/FFT/DS1Z_QuickPrint13.png
