ravotus/FaucetLED/hardware/MAX4257_10pF/FFT/DS1Z_QuickPrint15.png

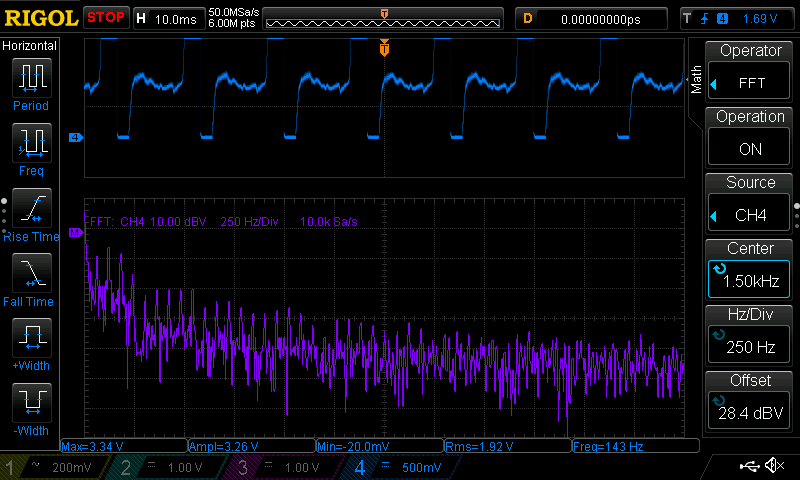
hardware/MAX4257_10pF/FFT/DS1Z_QuickPrint15.png
