ravotus/FaucetLED/resources/FixPoint.pdf

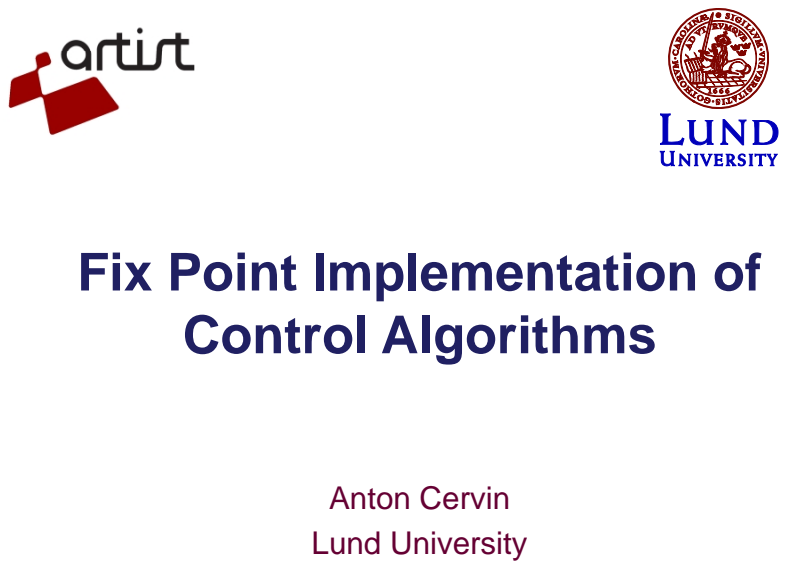
[picture p39: page 1]
l Algor; hms; v Lund University

Fix Point Implementation of
Contro

### Outline

- A-D and D-A Quantization
- Computer arithmetic
⁻ | Floating-point arithmetic
⁻ | Fixed-point arithmetic
- Controller realizations

Graduate Course on Embedded Control Systems – Pisa 8-12 June 2009

### Finite-Wordlength Implementation

Control analysis and design usually assumes infinite-precision arithmetic, parameters/variables are assumed to be real numbers

Error sources in a digital implementation with finite wordlength:

- Quantization in A-D converters
- Quantization of parameters (controller coefficients)
- Round-off and overflow in addition, subtraction, multiplication, division, function evaluation and other operations
- Quantization in D-A converters

The magnitude of the problems depends on

- The wordlength
- The type of arithmetic used (fixed or floating point)
- The controller realization

### A-D and D-A Quantization

A-D and D-A converters often have quite poor resolution, e.g.

- A-D: 10–16 bits
- D-A: 8–12 bits

Quantization is a nonlinear phenomenon; can lead to limit cycles and bias. Analysis approaches:

- Nonlinear analysis
⁻ | Describing function approximation
⁻ | Theory of relay oscillations
- Linear analysis
⁻ Model quantization as a stochastic disturbance

### Example: Control of the Double Integrator

Process:
P

(

s) =
1

/
s

2

Sampling period:
h

=
1

Controller (PID):

C

(

z) = 0.715

z

2
− 1.281
z

+ 0.580
(
z

−

1)(
z

+ 0.188

)

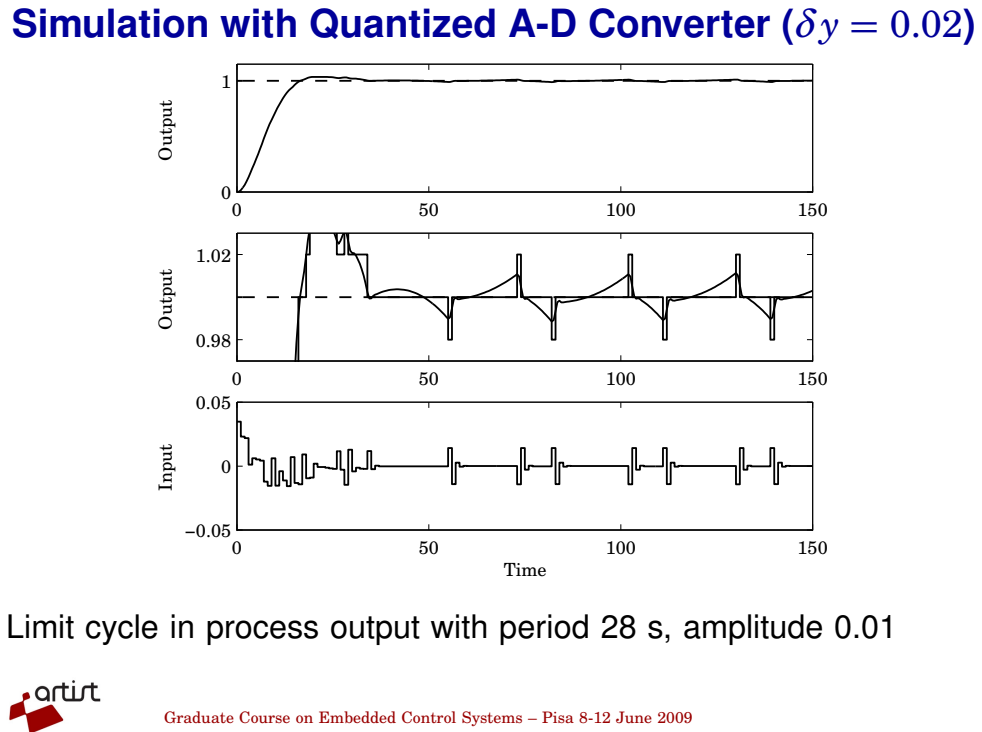
[picture p40: page 7]
Output; Time; Input

Simulation with Quantized A-D Converter (

Limit cycle in process output with period 28 s, amplitude 0.0

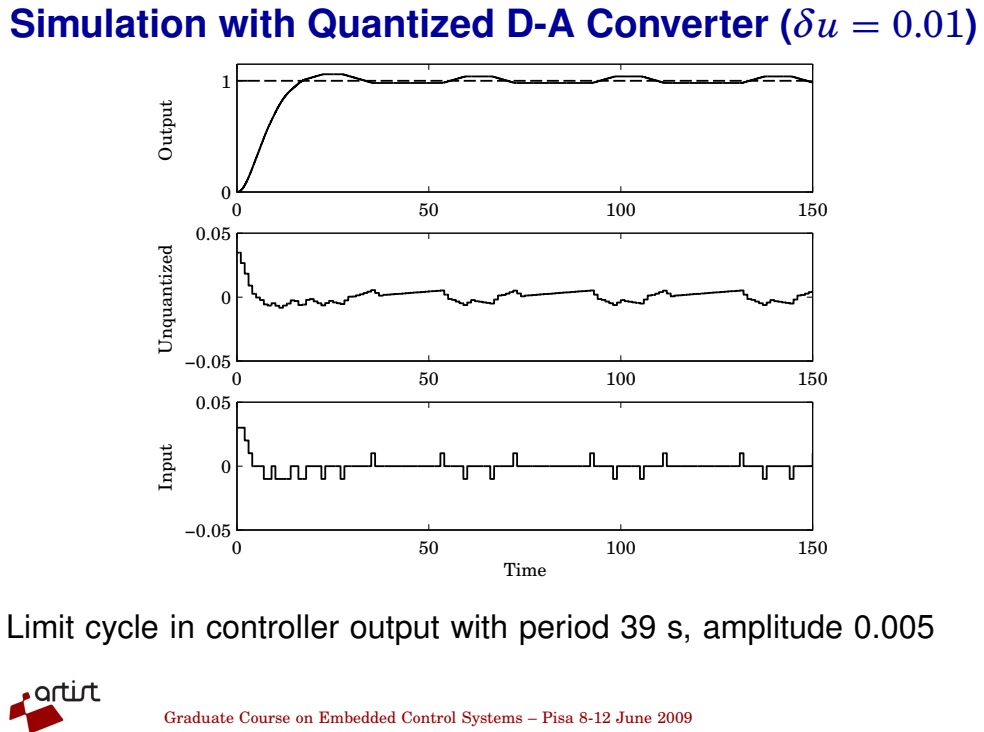
[picture p41: page 8]
Output; Unquantized; Time; Input

Simulation with Quantized D-A Converter (

Limit cycle in controller output with period 39 s, amplitude 0.005

### Describing Function Analysis

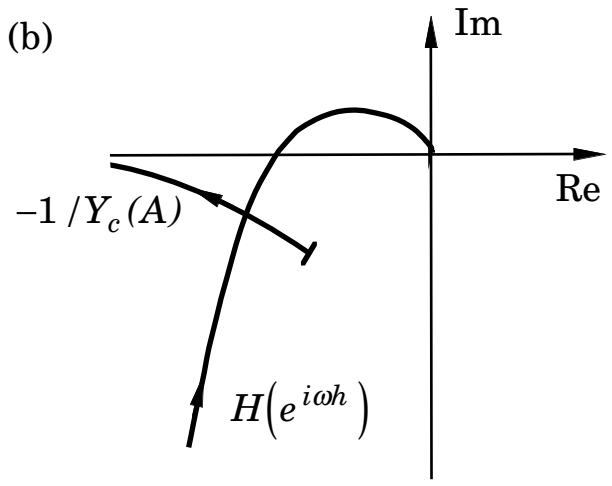
[picture p42: figure]
iωh (

(a) (b)

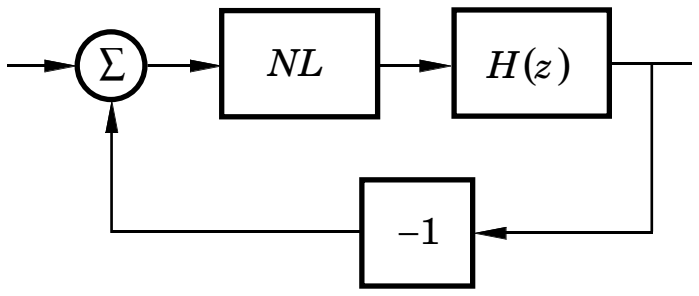
[picture p43: figure]

Limit cycle with frequency ω

### 1 and amplitude

A

### 1 predicted if

H

(
e

iω
1
h) = −

1
Yc

(
A
1

)

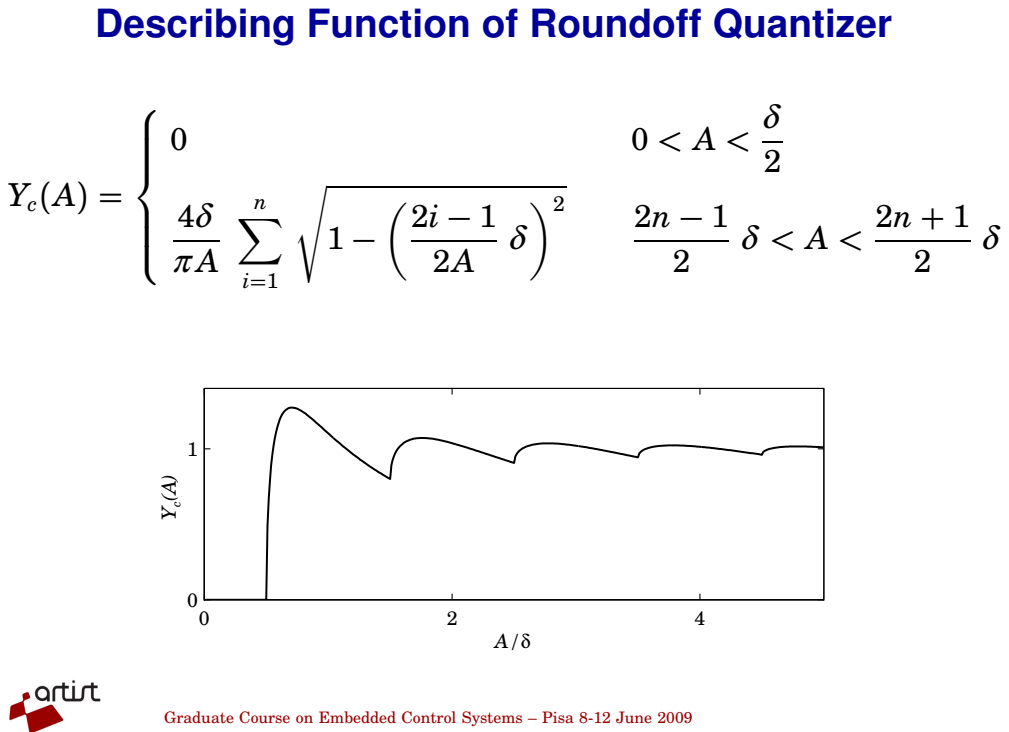
[picture p44: page 10]
Describing Function of Roundoff Quantizer

### Nyquist Curve of Sampled Loop Transfer Function

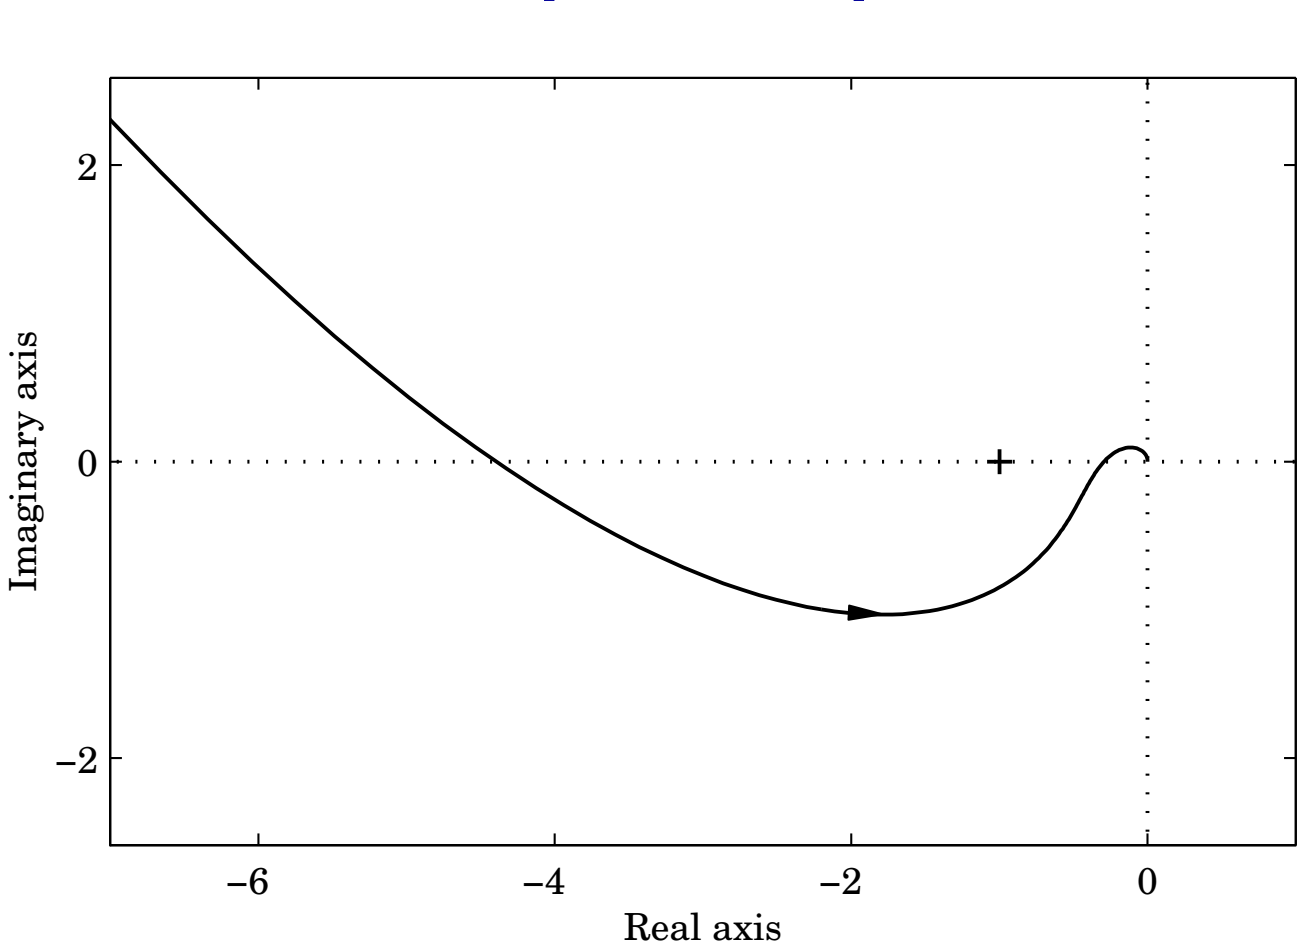
[picture p45: figure]
Imaginary axis; Real axis

First crossing at
ω
1

= 0.162 rad/s. Predicts limit cycle with period

### 39 s and amplitude

A
1

=
δ

/
2.

### Linear Analysis of Quantization Noise

y

a

π
Q

π

∑

y

a | e
a

Roundoff quantization:
e

a uniformly distributed over [− δ

/2,
δ

/

2],

V

(
e
a) =
δ

2
/12

### Pulse-Width Modulation (PWM)

Poor D-A resolution (e.g. 1 bit) can often be handled by fast switching between levels + low-pass filtering

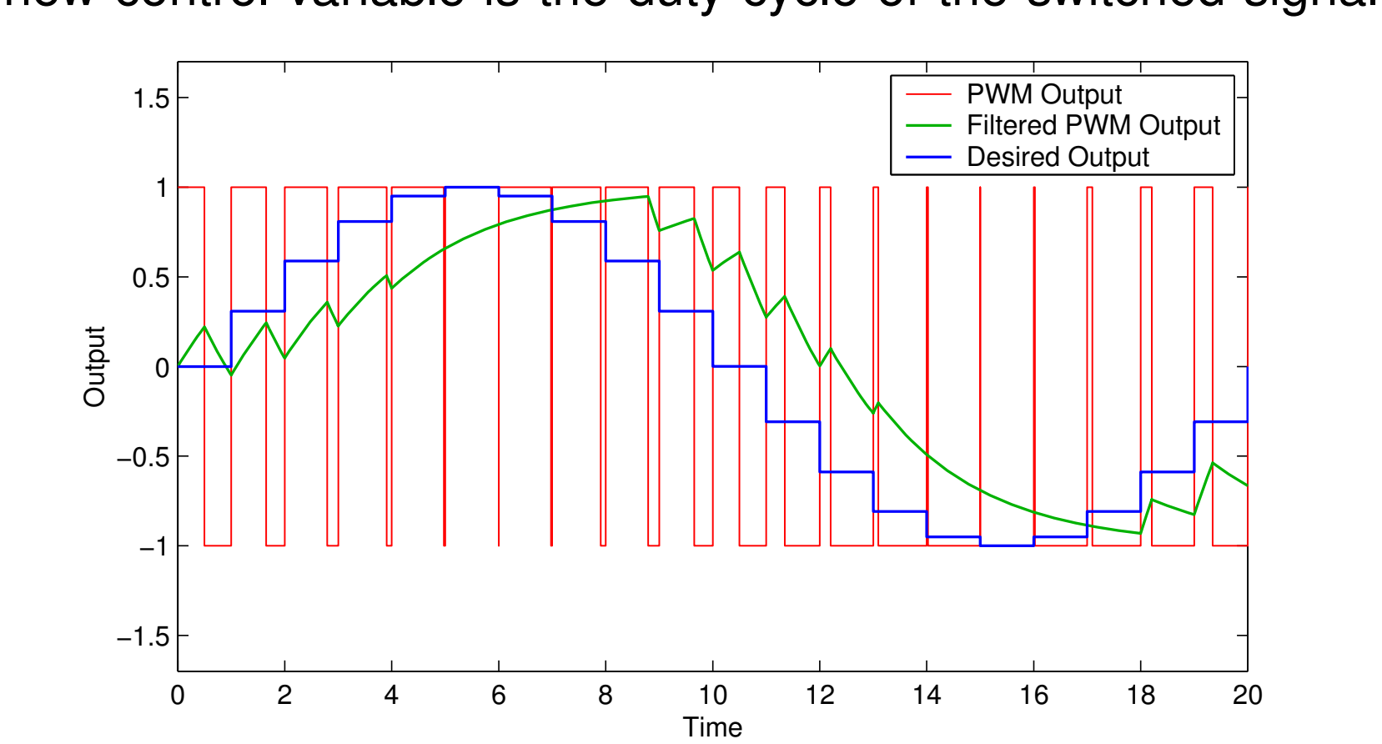
[picture p46: figure]
Time; Output; PWM Output Filtered PWM Output Desired Output

The new control variable is the duty-cycle of the switched signal

### Floating-Point Arithmetic

Hardware-supported on modern high-end processors (FPUs)

Number representation:
±
f

$
2

±
e

•

f: mantissa, significand, fraction •

2: base
•

e: exponent

The binary point is variable (floating) and depends on the value of the exponent

Dynamic range and resolution

Fixed number of significant digits

### IEEE 754 Binary Floating-Point Standard

Used by almost all FPUs; implemented in software libraries

Single precision (Java/C float):

- 32-bit word divided into 1 sign bit, 8-bit biased exponent, and 23-bit mantissa (

(

### 7 decimal digits)

- Range:
2

−126
−

2¹²⁸

Double precision (Java/C double):

- 64-bit word divided into 1 sign bit, 11-bit biased exponent, and 52-bit mantissa (

( 15 decimal digits)
- Range:
2

−1022
−

2¹⁰²⁴

Supports Inf and NaN

### What is the output of this program?

#include <stdio.h>

main() {

float a[] = { 10000.0, 1.0, 10000.0 }; float b[] = { 10000.0, 1.0, -10000.0 }; float sum = 0.0;
int i;

for (i=0; i<3; i++)
sum += a[i]*b[i];

printf("sum = %f\n", sum); }

Remarks:

- The result depends on the order of the operations
- Finite-wordlength operations are neither associative nor distributive

### Arithmetic in Embedded Systems

Small microprocessors used in embedded systems typically do not have hardware support for floating-point arithmetic

Options:

- Software emulation of floating-point arithmetic
⁻ | compiler/library supported
⁻ | large code size, slow
- Fixed-point arithmetic
⁻ | often manual implementation
⁻ | fast and compact

### Fixed-Point Arithmetic

Represent all numbers (parameters, variables) using integers

Use binary scaling to make all numbers fit into one of the integer data types, e.g.

- 8 bits (char, int8_t): [−128, 127]
- 16 bits (short, int16_t): [−32768, 32767]
- 32 bits (long, int32_t): [−2147483648, 2147483647]

### Challenges

- Must select data types to get sufficient numerical precision
- Must know (or estimate) the minimum and maximum value of every variable in order to select appropriate scaling factors
- Must keep track of the scaling factors in all arithmetic operations
- Must handle potential arithmetic overflows

### Fixed-Point Representation

In fixed-point representation, a real number

x is represented by an
integer

X with
N

=
m

+
n

+

### 1 bits, where

•

N is the wordlength
•

m is the number of integer bits (excluding the sign bit) •

n is the number of fractional bits

Sign bit | Integer bits | Fractional bits

0 0 1
1

0
1

1

1

“Q-format”:

X is sometimes called a Qm.n or Qn number

### Conversion to and from fixed point

Conversion from real to fixed-point number:

X := round

(
x ⋅ 2

n
)

Conversion from fixed-point to real number:

x :=
X ⋅ 2

−
n

Example: Represent
x

= 13.4 using
Q4.3 format

X

= round

(13.4 ⋅ 2

3) = 107 (= 01101011
2

)

### A Note on Negative Numbers

In almost all CPUs today, negative integers are handled usin

g
two’s complement: A “1” in the sign bit means that
2

N should be
subtracted

Example (
N

=
8):

Binary representation Interpretation 00000000 0
00000001 1

01111111 127
10000000 -128
10000001 -127

1111111 -1

### Range vs Resolution for Fixed-Point Numbers

A Qm.n fixed-point number can represent real numbers in the range
[−
2

m, 2

m
−
2

n
]
while the resolution is
2

−
n

Fixed range and resolution

•

n too small

[ poor resolution
•

n too large

[ risk of overflow

### Fixed-Point Addition/Subtraction

Two fixed-point numbers in the same Qm.n format can be added or subtracted directly

The result will have the same number of fractional bits

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
- The result will in general require N

+

### 1 bits; risk of overflow

### Example: Addition with Overflow

Two numbers in

Q4.3 format are added:

x

= 12.25

[
X

= 98

y

= 14.75

[
Y

= 118

Z

=
X

+
Y

= 216

This number is however out of range and will be interpreted as

216

− 256 = −40

[

z = −5.0

0 | 0 | 0 0
0 | 0 | 0
0 | 0 | 0 0

0

1 | 1 | 1 1

1

1 | 1 | 1 | 1

1

1

1

+

=

### Fixed-Point Multiplication and Division

If the operands and the result are in the same Q-format, multiplication and division are done as

z

=
x ⋅ y

\

Z = (

X ⋅ Y)/
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
Z = (
X ⋅ 2

n)/
Y
- Double wordlength is needed for the intermediate result
- Division by
2

n is implemented as a right-shift by n bits
- Multiplication by
2

n is implemented as a left-shift by n bits
- The lowest bits in the result are truncated (round-off noise

)
- Risk of overflow

### Example: Multiplication

Two numbers in

Q5.2 format are multiplied:

x

= 6.25

[
X

= 25

y

= 4.75

[
Y

= 19

Intermediate result:
X ⋅ Y

= 475

Final result:
Z

= 475

/
2

2
= 118

[
z

= 29.5

(exact result is 29.6875)

0

0 | 0 0 | 0
0 | 0 0 | 0 0

1

1 1

$ | 1 | 1 | 1

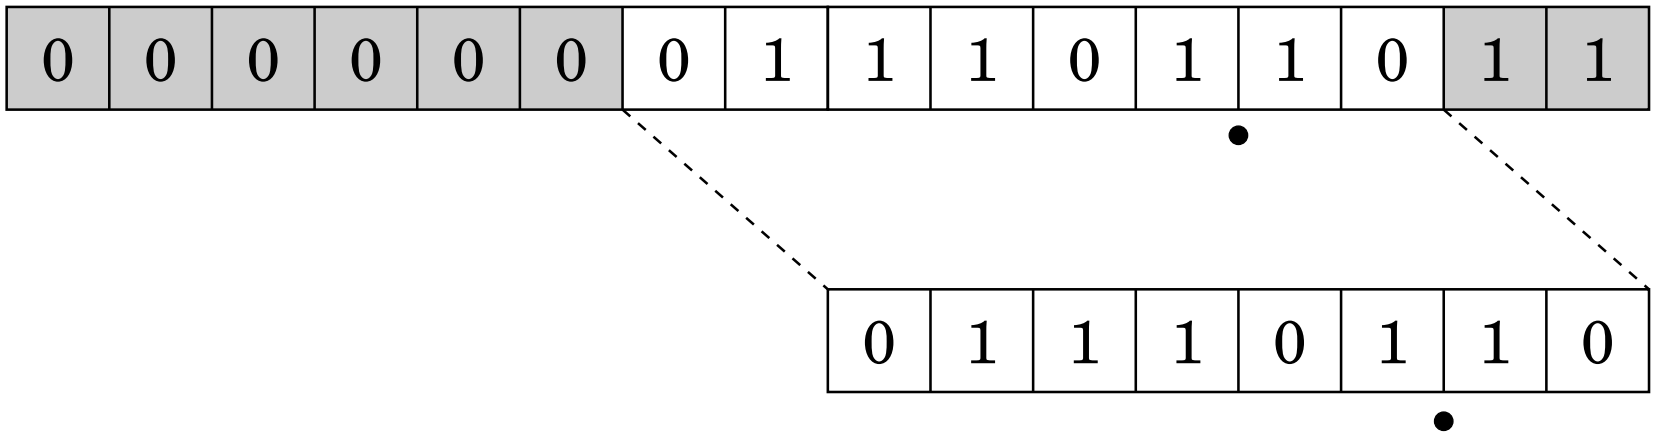
[picture p47: figure]

=

### Multiplication of Operands with Different Q-format

In general, multiplication of two fixed-point numbers Qm
1.n

### 1 and

Qm
2.n

### 2 gives an intermediate result in the format

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
which may then be right-shifted n
1

+
n
2

−
n

### 3 steps and stored in the

format
Qm

3.n
3

Common case:
n
2

=
n
3

=
0 (one real operand, one integer operand, and integer result). Then

Z = (

X ⋅ Y)/
2

n
1

### Implementation of Multiplication in C

Assume

Q4.3 operands and

Q4.3 result

#include <inttypes.h> | /* define int8_t, etc. (Linux only) | * /

#define n 3 | /* number of fractional bits | */

int8_t X, Y, Z; | /* Q4.3 operands and result | */
int16_t temp; | /* Q9.6 intermediate result | */
temp = (int16_t)X * Y; | /* cast operands to 16 bits and multiply */
temp = temp >> n; | /* divide by 2^n | */
Z = temp; | /* truncate and assign result | */

### Implementation of Multiplication in C with Rounding and Saturation

#include <inttypes.h> | /* defines int8_t, etc. (Linux only) | */

#define n 3 | /* number of fractional bits | */

int8_t X, Y, Z; | /* Q4.3 operands and result | */
int16_t temp; | /* Q9.6 intermediate result | */
temp = (int16_t)X * Y; | /* cast operands to 16 bits and multiply */
temp = temp + (1 << n-1); /* add 1/2 to give correct rounding | */
temp = temp >> n; | /* divide by 2^n | */
if (temp > INT8_MAX) | /* saturate the result before assignment */
Z = INT8_MAX;
else if (temp < INT8_MIN)
Z = INT8_MIN;
else
Z = temp;

### Implementation of Division in C with Rounding

#include <inttypes.h> | /* define int8_t, etc. (Linux only) | * /

#define n 3 | /* number of fractional bits | */

int8_t X, Y, Z; | /* Q4.3 operands and result | */
int16_t temp; | /* Q9.6 intermediate result | */
temp = (int16_t)X << n; | /* cast operand to 16 bits and shift | */
temp = temp + (Y >> 1); | /* Add Y/2 to give correct rounding | */
temp = temp / Y; | /* Perform the division (expensive!) | */
Z = temp; | /* Truncate and assign result | */

### Example: Atmel mega8/16 instruction set

Mnemonic Description | # clock cycles
ADD | Add two registers | 1
SUB | Subtract two registers | 1
MULS | Multiply signed | 2
ASR | Arithmetic shift right (1 step) | 1
LSL | Logical shift left (1 step) | 1
- No division instruction; implemented in math library using expensive division algorithm

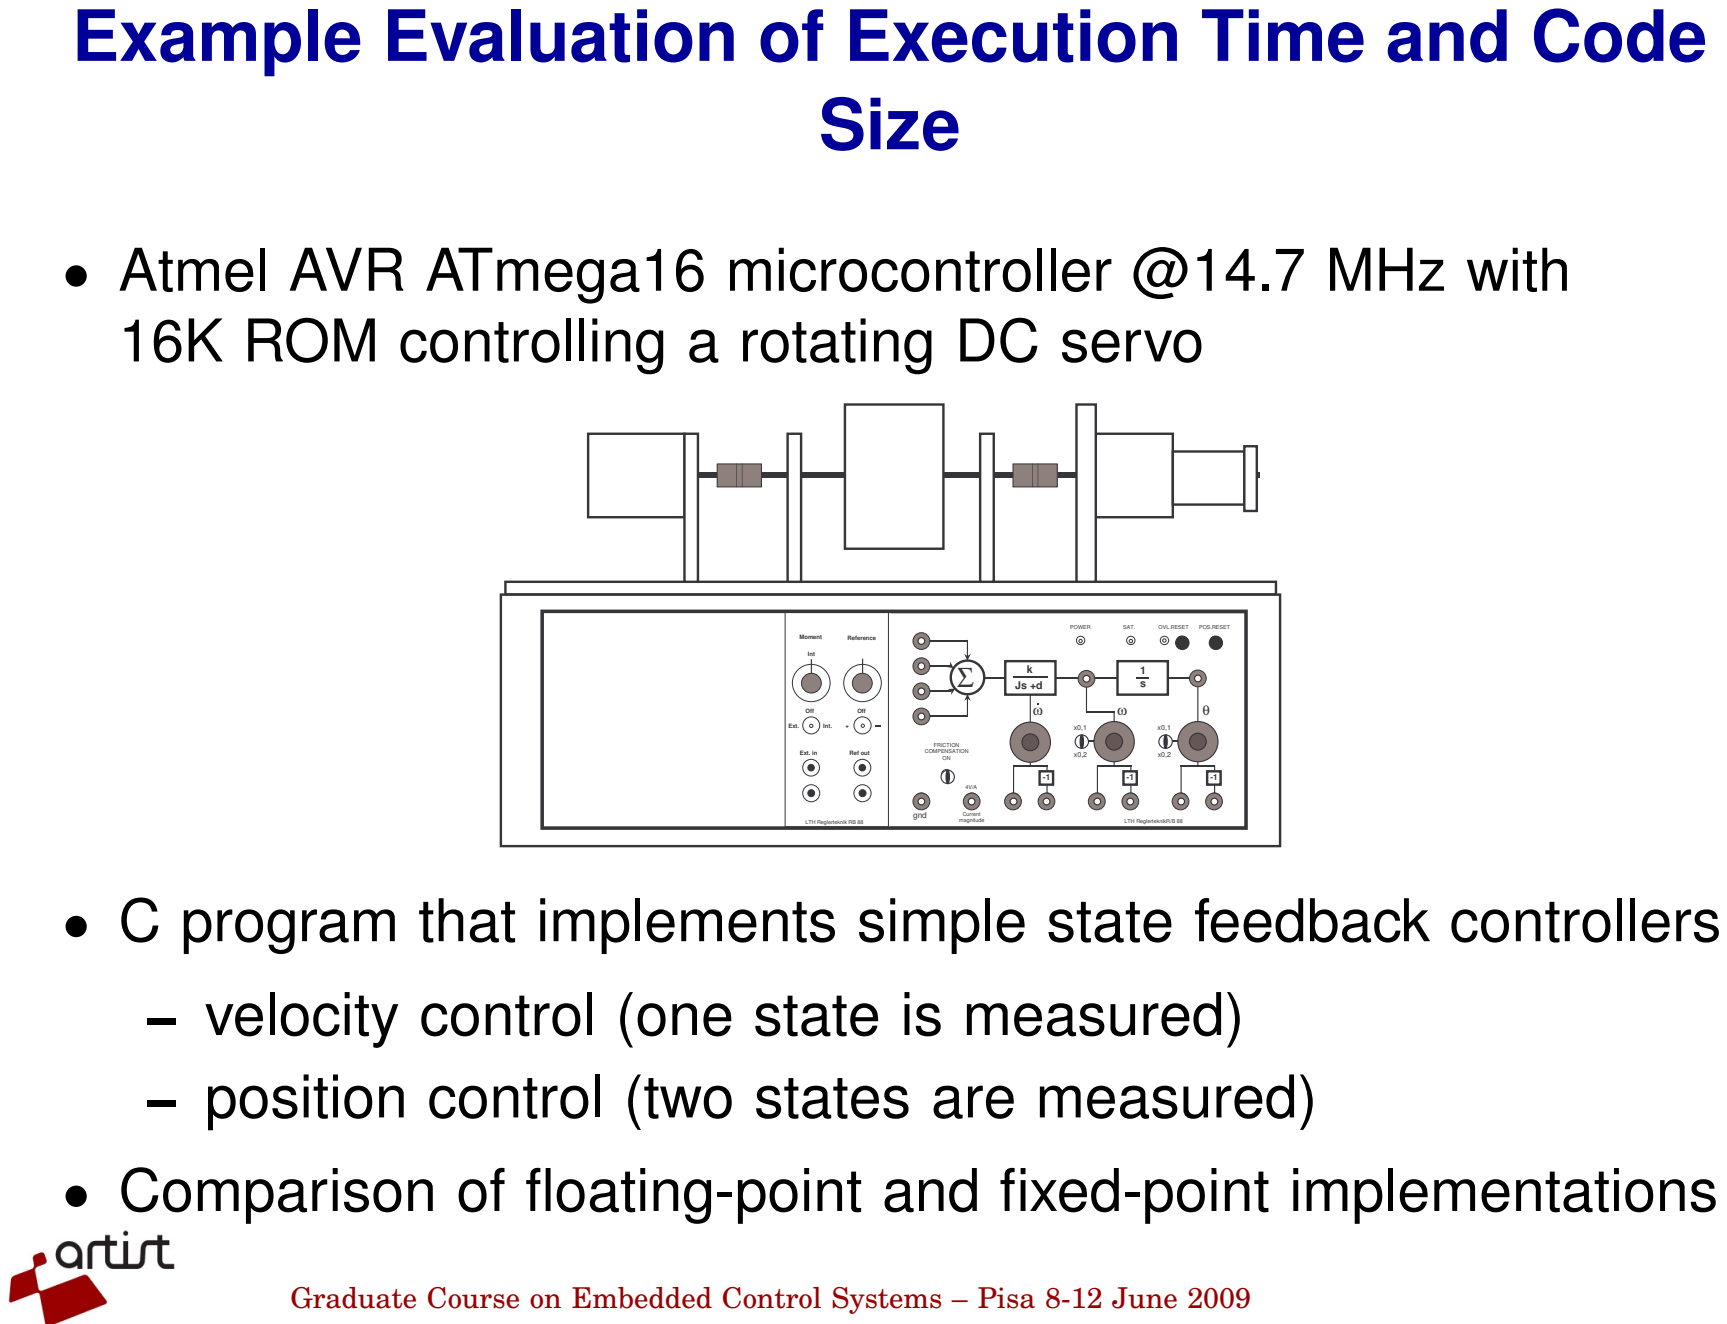
[picture p48: page 36]
Size; gnd; FRICTION COMPENSATION ON; POWER; SAT.; OVL.RESET; POS.RESET; LTH ReglerteknikּR/B 88; Current magnitude; Ext. in; Moment; Ext.; Int.; Int; Off; Reference; Ref out; velocity control (one state is measured); position control (two states are measured)

Example Evaluation of Execution Time and Code

• Atmel AVR ATmega16 microcontroller @14.7 MHz with
16K ROM controlling a rotating DC servo

LTH Reglerteknik RB 88

• C program that implements simple state feedback controller
• Comparison of floating-point and fixed-point implementations

### Example Evaluation: Fixed-Point Implementation

The position controller (with integral action) is given by

u

(

k) =
l
1

y
1

(

k) +
l
2

y
2

(

k) +
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
1) =
I

(

k) +
r

(

k) −
y
2

(
k

)

where
l

1 = −5.0693,
l

2 = −5.6855,
l
3

= 0.6054

Choose fixed-point representations assuming word length N

= 16

•

y

1, y

2, u, r are integers in the interval [−512, 511] ∈ Q10.0
- Let
I

∈
Q16.0 to simplify the addition
- Use

Q4.12 for the coefficients, giving

L

1 = −20764,
L

2 = −23288,
L
3

= 2480

### Example Evaluation: Pseudo-C Code

#define L1 -20764 /* Q4.12 */

#define L2 -23288 /* Q4.12 */

#define L3 2480 | /* Q4.12 */

#define QF 12 | /* number of fractional bits in L1,L2,L3 */

int16_t y1, y2, r, u, I=0; /* Q16.0 variables */
for (;;) {
y1 = readInput(1); | /* read Q10.0, store as Q16.0 */
y2 = readInput(2); | /* read Q10.0, store as Q16.0 */
r = readReference();
u = ((int32_t)L1*y1 + (int32_t)L2*y2 + (int32_t)L3*I) >> QF;
if (u >= 512) u = 511; /* saturate to fit into Q10.0 output */ if (u < -512) u = -512;
writeOutput(u); | /* write Q10.0 */
I += r - y2; | /* TODO: saturation and tracking... */
sleep();
}

### Example Evaluation: Measurements

Floating-point implementation using float

s:

- Velocity control: 950
µs
- Position control: 1220

µs
- Total code size: 13708 bytes

Fixed-point implementation using 16-bit integers:

- Velocity control: 130
µs
- Position control: 270

µs
- Total code size: 3748 bytes

One A-D conversion takes about 115

µs. This gives a 25–50
times speedup for fixed point math compared to floating point. The floating point math library takes about 10K (out of 16K available!)

### Controller Realizations

A linear controller

H

(

z) =

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
+ . . .

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
+ . . .

+
a
n

z

−
n

can be realized in a number of different ways with equivalent input-output behavior, e.g.

- Direct form
- Companion (canonical) form
- Series (cascade) or parallel form

### Direct Form

The input-output form can be directly implemented as

u(k) = X

n

i=0

biy(k − i) −X

n

i=1

aiu(k − i)

- Nonminimal (all old inputs and outputs are used as states)
- Very sensitive to roundoff in coefficients
- Avoid!

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

### Pole Sensitivity

How sensitive are the poles to errors in the coefficients?

Assume characteristic polynomial with distinct roots. Then

A(z) = 1 −X

n

k=1

akz⁻k = Y

n

j=1

(1 − pj z⁻¹)

Pole sensitivity:
pi
ak

The chain rule gives

A(z)
pi

pi
ak

=

A(z)
ak

Evaluated in z = pi we get

pi
ak

=

pn−k
Q

i
n
j=1,j,=i(pi − pj)
- Having poles close to each other is bad
- For stable filter, an is the most sensitive parameter

### Better: Series and Parallel Forms

Divide the transfer function of the controller into a number of first-or second-order subsystems:

Direct Form | Series Form

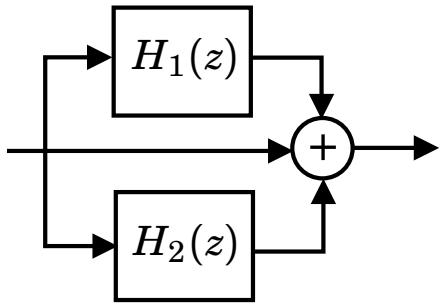
[picture p49: figure]

Parallel Form

H(z)
H

1(z)
H

2(z)

- Try to balance the gain such that each subsystem has about the same amplification

### Example: Series and Parallel Forms

C

(

z) =

z

4
− 2.13
z

3
+ 2.351
z

2
− 1.493
z

+ 0.5776
z

4
− 3.2
z

3
+ 3.997
z

2
− 2.301
z

+ 0.5184

(Direct

)

=

z

2
− 1.635
z

+ 0.9025
z

2
− 1.712
z

+ 0.81
z

2
− 0.4944
z

+ 0.64
z

2
− 1.488
z

+ 0.64

(Series

)

=
1

+

−5.396
z

+ 6.302
z

2
− 1.712
z

+ 0.81

+

6.466

z

− 4.907
z

2
− 1.488
z

+ 0.64

(Parallel

)

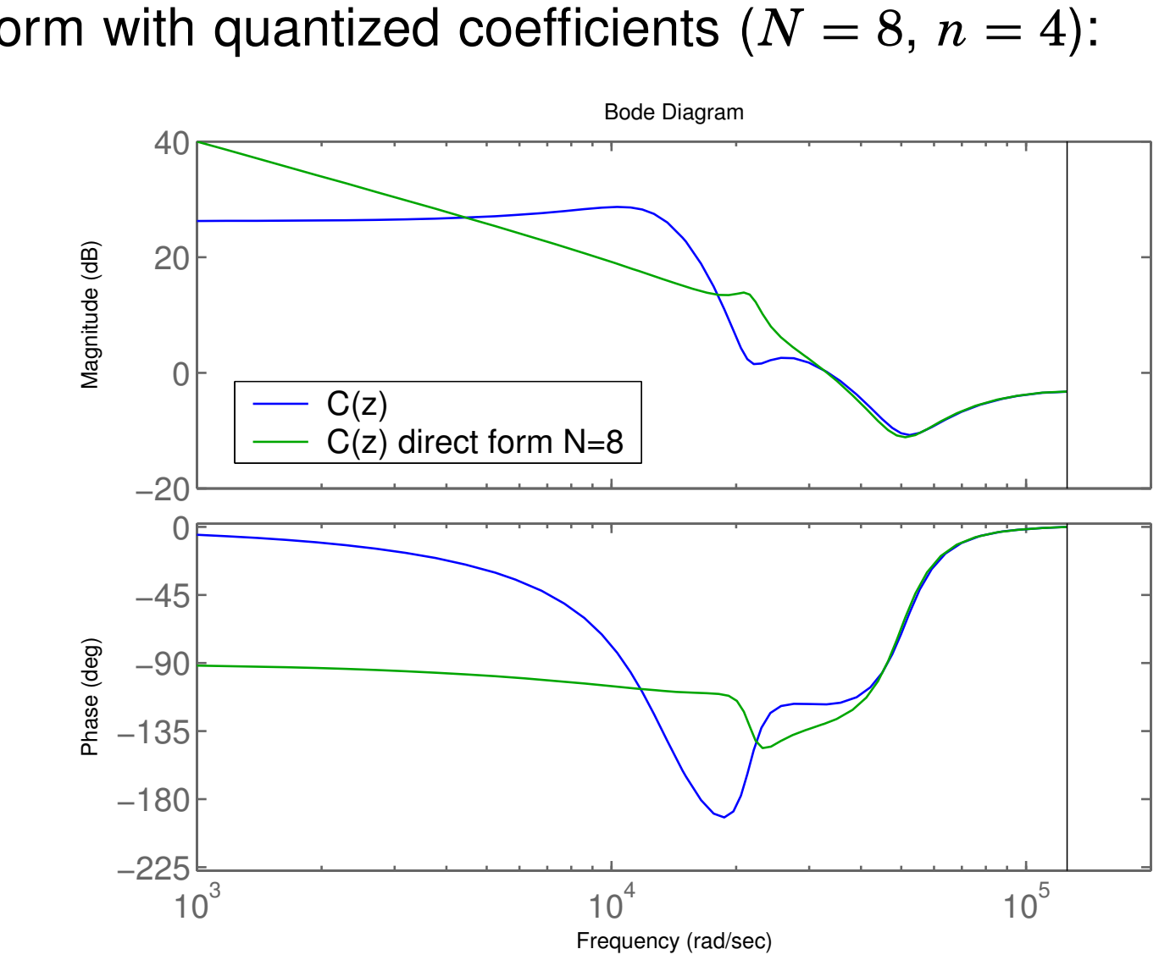
[picture p50: figure]
Bode Diagram; Frequency (rad/sec); Phase (deg) Magnitude (dB) −20; C(z) C(z) direct form N=8

Direct form with quantized coefficients (

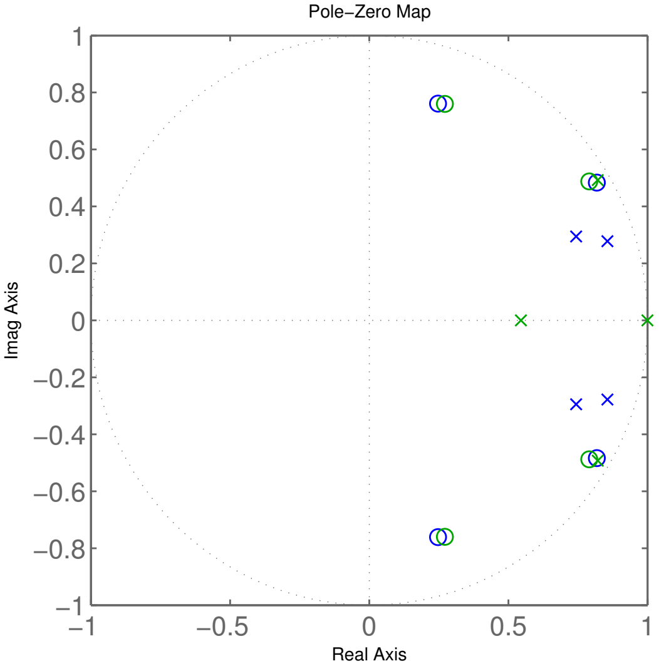
[picture p51: figure]
Pole−Zero Map; Real Axis; Imag Axis

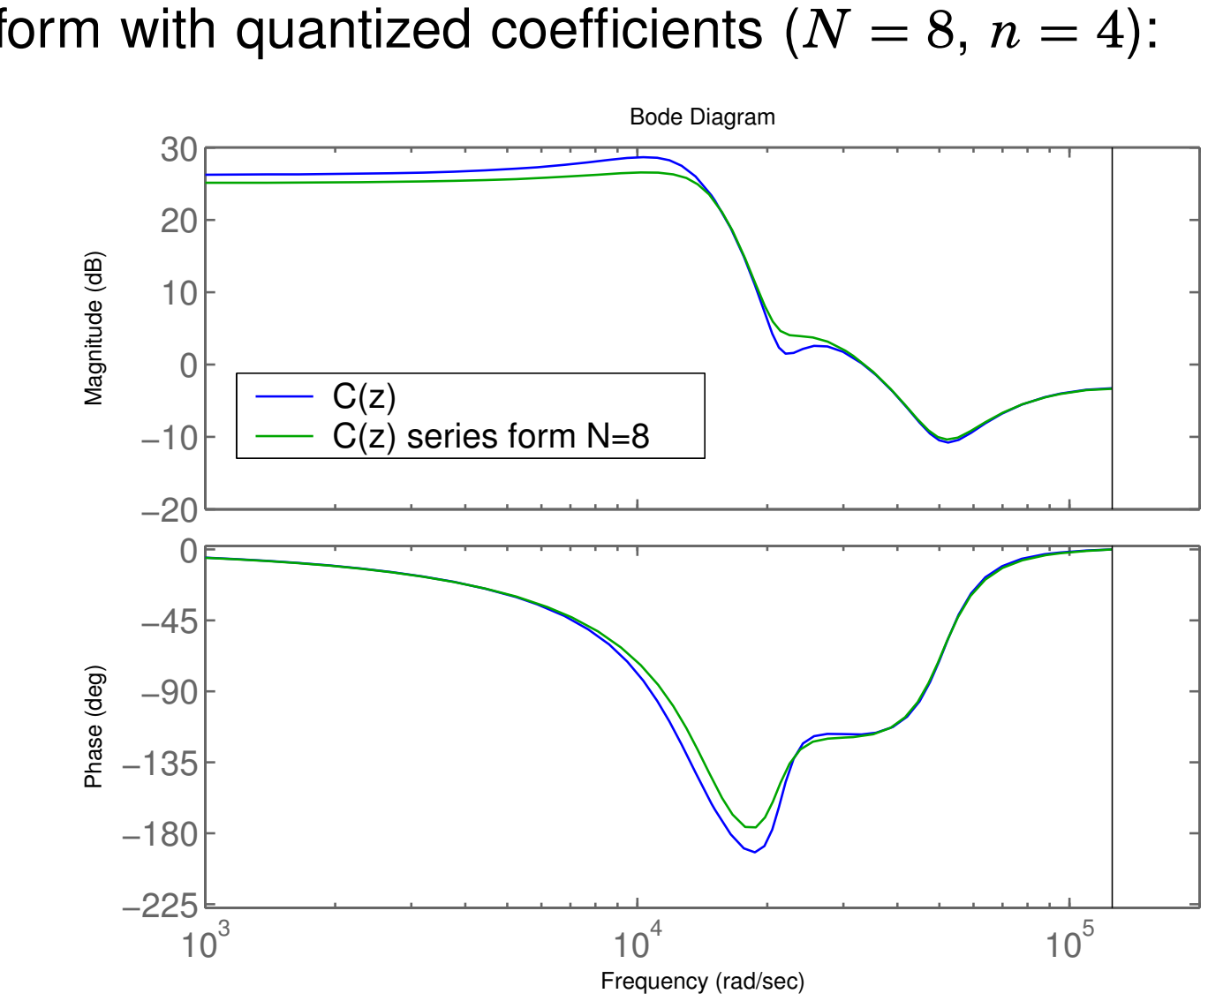
[picture p52: figure]
Bode Diagram; Frequency (rad/sec); Phase (deg) Magnitude (dB) −20 −10; C(z) C(z) series form N=8

Series form with quantized coefficients (

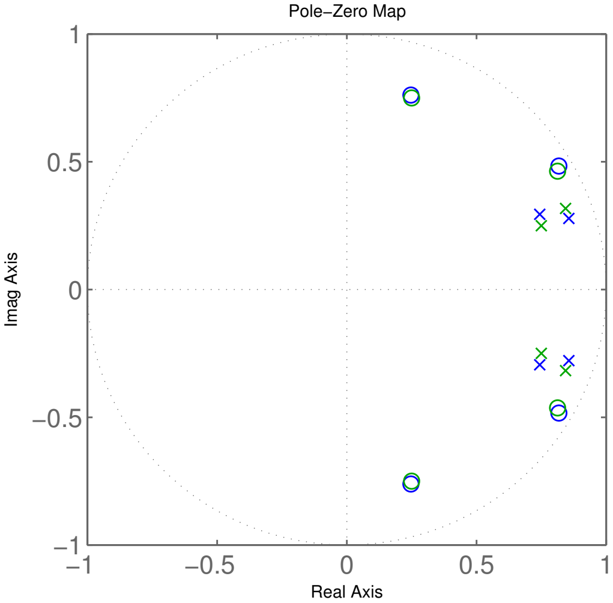
[picture p53: figure]
Pole−Zero Map; Real Axis; Imag AxisC(z) C(z) cascade form N=8

### Jackson’s Rules for Series Realizations

How to pair and order the poles and zeros?

Jackson’s rules (1970):

- Pair the pole closest to the unit circle with its closest zero. Repeat until all poles and zeros are taken.
- Order the filters in increasing or decreasing order based on the poles closeness to the unit circle.

This will push down high internal resonance peaks.

### Well-Conditioned Parallel Realizations

Assume
n

r distinct real poles and
n

c distinct complex-pole pairs

Modal (a.k.a. diagonal/parallel/coupled) form:

zi(
k

+

1) =
λ izi(
k) +
β iy

(
k

)
i

= 1, . . . ,
n
r

vi(
k

+

1) =

σ i ω i
−
ω i σ i
vi(
k) +

γ i1

γ i2

y

(
k

)
i

= 1, . . . ,
n
c

u

(

k) = D y

(

k) +

Xn
| r

i=
1

γ izi(

k) +

Xn
c

i=
1

δ

T
i vi(
k

)

Matlab: sysm = canon(sys,’modal’)

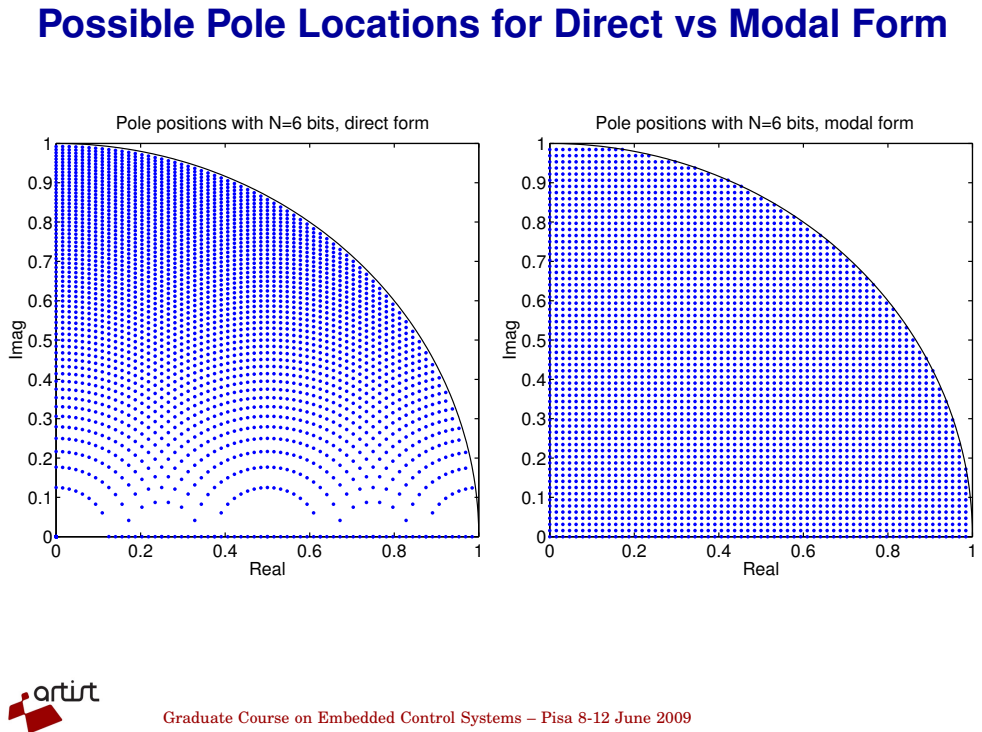
[picture p54: page 53]
Real; Imag

Possible Pole Locations for Direct vs Modal Form

Pole positions with N=6 bits, direct form

Pole positions with N=6 bits, modal form

### Short Sampling Interval Modification

In the state update equation

x

(
k

+

1) =
Φ
x

(

k) +
Γ
y

(
k

)

the system matrix

Φ will be close to

I if

h is small. Round-off
errors in the coefficients of

Φ can have drastic effects.

Better: use the modified equation

x

(
k

+

1) =
x

(

k) + (
Φ

−
I

)
x

(

k) +
Γ
y

(
k

)

- Both
Φ

−
I and

Γ are roughly proportional to h
⁻ Less round-off noise in the calculations
- Also known as the
| δ -form

### Short Sampling Interval and Integral Action

Fast sampling and slow integral action can give roundoff problems:

I

(
k

+

1) =
I

(

k) +
e

(
k

) ⋅ h

/
Ti
| {z

}
(
0

Possible solutions:

- Use a dedicated high-resolution variable (e.g. 32 bits) for the I-part
- Update the I-part at a slower rate

General problem for filters with very different time constants
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
