ravotus/FaucetLED/resources/Enclosure CU-18420-B.pdf

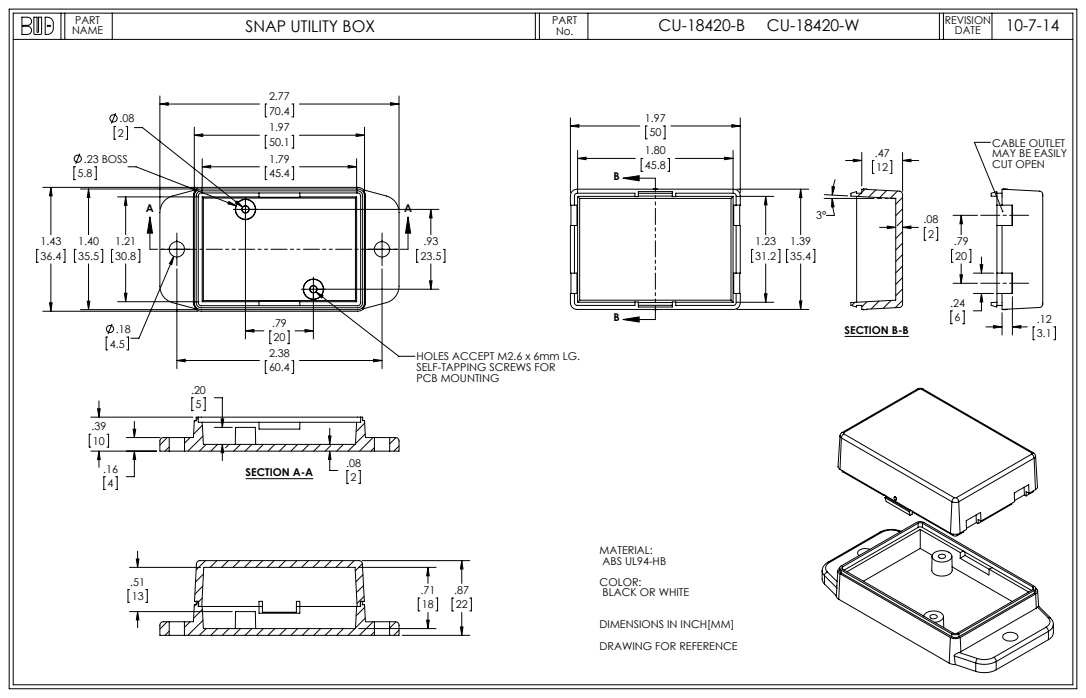
[picture p55: page 1]
SECTION A-A; SECTION B-B; SNAP UTILITY BOX; 10-7-14 PART

CABLE OUTLET
MAY BE EASILY
CUT OPEN

HOLES ACCEPT M2.6 x 6mm LG.
SELF-TAPPING SCREWS FOR
PCB MOUNTING

MATERIAL:
ABS UL94-HB
COLOR:
BLACK OR WHITE

DIMENSIONS IN INCH[MM]
DRAWING FOR REFERENCE
