ravotus/FaucetLED/FaucetLED/Src/main.c

/**
  ******************************************************************************
  * File Name          : main.c
  * Description        : Main program body
  ******************************************************************************
  *
  * Copyright (c) 2017 STMicroelectronics International N.V. 
  * All rights reserved.
  *
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
  ******************************************************************************
  */
/* Includes ------------------------------------------------------------------*/
#include "main.h"
#include "stm32l0xx_hal.h"
#include "cmsis_os.h"

/* USER CODE BEGIN Includes */
#include "app.h"
#include "drivers/led.h"
/* USER CODE END Includes */

ADC_HandleTypeDef hadc;

IWDG_HandleTypeDef hiwdg;

LPTIM_HandleTypeDef hlptim1;

TIM_HandleTypeDef htim2;

TSC_HandleTypeDef htsc;

osThreadId WatchdogHandle;
uint32_t WatchdogBuffer[ 128 ];
osStaticThreadDef_t WatchdogControlBlock;
osThreadId LedHandle;
uint32_t LedBuffer[ 128 ];
osStaticThreadDef_t LedControlBlock;
osThreadId AdcReaderHandle;
uint32_t AdcReaderBuffer[ 128 ];
osStaticThreadDef_t AdcReaderControlBlock;
osMessageQId LedCmdQHandle;
uint8_t LedCmdQBuffer[ 4 * sizeof( LedCmd_S ) ];
osStaticMessageQDef_t LedCmdQControlBlock;
osMessageQId TouchDataQHandle;
uint8_t TouchDataQBuffer[ 2 * sizeof( uint16_t ) ];
osStaticMessageQDef_t TouchDataQControlBlock;

/* USER CODE BEGIN PV */
/* USER CODE END PV */

void SystemClock_Config(void);
void Error_Handler(void);
static void MX_GPIO_Init(void);
static void MX_ADC_Init(void);
static void MX_TIM2_Init(void);
static void MX_TSC_Init(void);
static void MX_LPTIM1_Init(void);
static void MX_IWDG_Init(void);
void WatchdogTask(void const * argument);
extern void LedTask(void const * argument);
extern void AdcReaderTask(void const * argument);

void HAL_TIM_MspPostInit(TIM_HandleTypeDef *htim);
                                

/* USER CODE BEGIN PFP */

/* USER CODE END PFP */

int main(void)
{

  /* MCU Configuration----------------------------------------------------------*/

  /* Reset of all peripherals, Initializes the Flash interface and the Systick. */
  HAL_Init();

  /* Configure the system clock */
  SystemClock_Config();

  /* Initialize all configured peripherals */
  MX_GPIO_Init();
  MX_ADC_Init();
  MX_TIM2_Init();
  MX_TSC_Init();
  MX_LPTIM1_Init();
  MX_IWDG_Init();

  /* USER CODE BEGIN 2 */
  HAL_GPIO_WritePin(LED_DBG_GPIO_Port, LED_DBG_Pin, GPIO_PIN_RESET);
  led_init(&LED_TIMER_DEV, LED_TIM_PERIOD);
  led_disable();
  /* USER CODE END 2 */

  /* USER CODE BEGIN RTOS_MUTEX */
  /* add mutexes, ... */
  /* USER CODE END RTOS_MUTEX */

  /* USER CODE BEGIN RTOS_SEMAPHORES */
  /* add semaphores, ... */
  /* USER CODE END RTOS_SEMAPHORES */

  /* USER CODE BEGIN RTOS_TIMERS */
  /* start timers, add new ones, ... */
  /* USER CODE END RTOS_TIMERS */

  /* Create the thread(s) */
  /* definition and creation of Watchdog */
  osThreadStaticDef(Watchdog, WatchdogTask, osPriorityHigh, 0, 128, WatchdogBuffer, &WatchdogControlBlock);
  WatchdogHandle = osThreadCreate(osThread(Watchdog), NULL);

  /* definition and creation of Led */
  osThreadStaticDef(Led, LedTask, osPriorityNormal, 0, 128, LedBuffer, &LedControlBlock);
  LedHandle = osThreadCreate(osThread(Led), NULL);

  /* definition and creation of AdcReader */
  osThreadStaticDef(AdcReader, AdcReaderTask, osPriorityBelowNormal, 0, 128, AdcReaderBuffer, &AdcReaderControlBlock);
  AdcReaderHandle = osThreadCreate(osThread(AdcReader), NULL);

  /* USER CODE BEGIN RTOS_THREADS */
  /* add threads, ... */
  /* USER CODE END RTOS_THREADS */

  /* Create the queue(s) */
  /* definition and creation of LedCmdQ */
  osMessageQStaticDef(LedCmdQ, 4, LedCmd_S, LedCmdQBuffer, &LedCmdQControlBlock);
  LedCmdQHandle = osMessageCreate(osMessageQ(LedCmdQ), NULL);

  /* definition and creation of TouchDataQ */
  osMessageQStaticDef(TouchDataQ, 2, uint16_t, TouchDataQBuffer, &TouchDataQControlBlock);
  TouchDataQHandle = osMessageCreate(osMessageQ(TouchDataQ), NULL);

  /* USER CODE BEGIN RTOS_QUEUES */
  /* add queues, ... */
  /* USER CODE END RTOS_QUEUES */
 

  /* Start scheduler */
  osKernelStart();
  
  /* We should never get here as control is now taken by the scheduler */

  /* Infinite loop */
  /* USER CODE BEGIN WHILE */
  while (1)
  {
  /* USER CODE END WHILE */

  /* USER CODE BEGIN 3 */

  }
  /* USER CODE END 3 */

}

/** System Clock Configuration
*/
void SystemClock_Config(void)
{

  RCC_OscInitTypeDef RCC_OscInitStruct;
  RCC_ClkInitTypeDef RCC_ClkInitStruct;
  RCC_PeriphCLKInitTypeDef PeriphClkInit;

    /**Configure the main internal regulator output voltage 
    */
  __HAL_PWR_VOLTAGESCALING_CONFIG(PWR_REGULATOR_VOLTAGE_SCALE1);

    /**Initializes the CPU, AHB and APB busses clocks 
    */
  RCC_OscInitStruct.OscillatorType = RCC_OSCILLATORTYPE_HSI|RCC_OSCILLATORTYPE_LSI;
  RCC_OscInitStruct.HSIState = RCC_HSI_ON;
  RCC_OscInitStruct.HSICalibrationValue = 16;
  RCC_OscInitStruct.LSIState = RCC_LSI_ON;
  RCC_OscInitStruct.PLL.PLLState = RCC_PLL_NONE;
  if (HAL_RCC_OscConfig(&RCC_OscInitStruct) != HAL_OK)
  {
    Error_Handler();
  }

    /**Initializes the CPU, AHB and APB busses clocks 
    */
  RCC_ClkInitStruct.ClockType = RCC_CLOCKTYPE_HCLK|RCC_CLOCKTYPE_SYSCLK
                              |RCC_CLOCKTYPE_PCLK1|RCC_CLOCKTYPE_PCLK2;
  RCC_ClkInitStruct.SYSCLKSource = RCC_SYSCLKSOURCE_HSI;
  RCC_ClkInitStruct.AHBCLKDivider = RCC_SYSCLK_DIV1;
  RCC_ClkInitStruct.APB1CLKDivider = RCC_HCLK_DIV16;
  RCC_ClkInitStruct.APB2CLKDivider = RCC_HCLK_DIV16;

  if (HAL_RCC_ClockConfig(&RCC_ClkInitStruct, FLASH_LATENCY_0) != HAL_OK)
  {
    Error_Handler();
  }

  PeriphClkInit.PeriphClockSelection = RCC_PERIPHCLK_LPTIM1;
  PeriphClkInit.LptimClockSelection = RCC_LPTIM1CLKSOURCE_LSI;

  if (HAL_RCCEx_PeriphCLKConfig(&PeriphClkInit) != HAL_OK)
  {
    Error_Handler();
  }

    /**Configure the Systick interrupt time 
    */
  HAL_SYSTICK_Config(HAL_RCC_GetHCLKFreq()/8000);

    /**Configure the Systick 
    */
  HAL_SYSTICK_CLKSourceConfig(SYSTICK_CLKSOURCE_HCLK_DIV8);

  /* SysTick_IRQn interrupt configuration */
  HAL_NVIC_SetPriority(SysTick_IRQn, 3, 0);
}

/* ADC init function */
static void MX_ADC_Init(void)
{

  ADC_ChannelConfTypeDef sConfig;

    /**Configure the global features of the ADC (Clock, Resolution, Data Alignment and number of conversion) 
    */
  hadc.Instance = ADC1;
  hadc.Init.OversamplingMode = DISABLE;
  hadc.Init.ClockPrescaler = ADC_CLOCK_ASYNC_DIV4;
  hadc.Init.Resolution = ADC_RESOLUTION_12B;
  hadc.Init.SamplingTime = ADC_SAMPLETIME_7CYCLES_5;
  hadc.Init.ScanConvMode = ADC_SCAN_DIRECTION_FORWARD;
  hadc.Init.DataAlign = ADC_DATAALIGN_RIGHT;
  hadc.Init.ContinuousConvMode = DISABLE;
  hadc.Init.DiscontinuousConvMode = DISABLE;
  hadc.Init.ExternalTrigConvEdge = ADC_EXTERNALTRIGCONVEDGE_NONE;
  hadc.Init.ExternalTrigConv = ADC_SOFTWARE_START;
  hadc.Init.DMAContinuousRequests = DISABLE;
  hadc.Init.EOCSelection = ADC_EOC_SINGLE_CONV;
  hadc.Init.Overrun = ADC_OVR_DATA_OVERWRITTEN;
  hadc.Init.LowPowerAutoWait = DISABLE;
  hadc.Init.LowPowerFrequencyMode = DISABLE;
  hadc.Init.LowPowerAutoPowerOff = ENABLE;
  if (HAL_ADC_Init(&hadc) != HAL_OK)
  {
    Error_Handler();
  }

    /**Configure for the selected ADC regular channel to be converted. 
    */
  sConfig.Channel = ADC_CHANNEL_3;
  sConfig.Rank = ADC_RANK_CHANNEL_NUMBER;
  if (HAL_ADC_ConfigChannel(&hadc, &sConfig) != HAL_OK)
  {
    Error_Handler();
  }

}

/* IWDG init function */
static void MX_IWDG_Init(void)
{

  hiwdg.Instance = IWDG;
  hiwdg.Init.Prescaler = IWDG_PRESCALER_32;
  hiwdg.Init.Window = 4095;
  hiwdg.Init.Reload = 4095;
  if (HAL_IWDG_Init(&hiwdg) != HAL_OK)
  {
    Error_Handler();
  }

}

/* LPTIM1 init function */
static void MX_LPTIM1_Init(void)
{

  hlptim1.Instance = LPTIM1;
  hlptim1.Init.Clock.Source = LPTIM_CLOCKSOURCE_APBCLOCK_LPOSC;
  hlptim1.Init.Clock.Prescaler = LPTIM_PRESCALER_DIV1;
  hlptim1.Init.Trigger.Source = LPTIM_TRIGSOURCE_SOFTWARE;
  hlptim1.Init.OutputPolarity = LPTIM_OUTPUTPOLARITY_HIGH;
  hlptim1.Init.UpdateMode = LPTIM_UPDATE_IMMEDIATE;
  hlptim1.Init.CounterSource = LPTIM_COUNTERSOURCE_INTERNAL;
  if (HAL_LPTIM_Init(&hlptim1) != HAL_OK)
  {
    Error_Handler();
  }

}

/* TIM2 init function */
static void MX_TIM2_Init(void)
{

  TIM_MasterConfigTypeDef sMasterConfig;
  TIM_OC_InitTypeDef sConfigOC;

  htim2.Instance = TIM2;
  htim2.Init.Prescaler = LED_TIM_CLK_DIV-1;
  htim2.Init.CounterMode = TIM_COUNTERMODE_UP;
  htim2.Init.Period = LED_TIM_PERIOD;
  htim2.Init.ClockDivision = TIM_CLOCKDIVISION_DIV1;
  if (HAL_TIM_PWM_Init(&htim2) != HAL_OK)
  {
    Error_Handler();
  }

  sMasterConfig.MasterOutputTrigger = TIM_TRGO_RESET;
  sMasterConfig.MasterSlaveMode = TIM_MASTERSLAVEMODE_DISABLE;
  if (HAL_TIMEx_MasterConfigSynchronization(&htim2, &sMasterConfig) != HAL_OK)
  {
    Error_Handler();
  }

  sConfigOC.OCMode = TIM_OCMODE_PWM1;
  sConfigOC.Pulse = 0;
  sConfigOC.OCPolarity = TIM_OCPOLARITY_HIGH;
  sConfigOC.OCFastMode = TIM_OCFAST_DISABLE;
  if (HAL_TIM_PWM_ConfigChannel(&htim2, &sConfigOC, TIM_CHANNEL_1) != HAL_OK)
  {
    Error_Handler();
  }

  if (HAL_TIM_PWM_ConfigChannel(&htim2, &sConfigOC, TIM_CHANNEL_2) != HAL_OK)
  {
    Error_Handler();
  }

  if (HAL_TIM_PWM_ConfigChannel(&htim2, &sConfigOC, TIM_CHANNEL_3) != HAL_OK)
  {
    Error_Handler();
  }

  HAL_TIM_MspPostInit(&htim2);

}

/* TSC init function */
static void MX_TSC_Init(void)
{

    /**Configure the TSC peripheral 
    */
  htsc.Instance = TSC;
  htsc.Init.CTPulseHighLength = TSC_CTPH_2CYCLES;
  htsc.Init.CTPulseLowLength = TSC_CTPL_2CYCLES;
  htsc.Init.SpreadSpectrum = DISABLE;
  htsc.Init.SpreadSpectrumDeviation = 1;
  htsc.Init.SpreadSpectrumPrescaler = TSC_SS_PRESC_DIV1;
  htsc.Init.PulseGeneratorPrescaler = TSC_PG_PRESC_DIV16;
  htsc.Init.MaxCountValue = TSC_MCV_16383;
  htsc.Init.IODefaultMode = TSC_IODEF_OUT_PP_LOW;
  htsc.Init.SynchroPinPolarity = TSC_SYNC_POLARITY_FALLING;
  htsc.Init.AcquisitionMode = TSC_ACQ_MODE_NORMAL;
  htsc.Init.MaxCountInterrupt = ENABLE;
  htsc.Init.ChannelIOs = TSC_GROUP5_IO4;
  htsc.Init.SamplingIOs = TSC_GROUP5_IO3;
  if (HAL_TSC_Init(&htsc) != HAL_OK)
  {
    Error_Handler();
  }

}

/** Configure pins as 
        * Analog 
        * Input 
        * Output
        * EVENT_OUT
        * EXTI
        * Free pins are configured automatically as Analog (this feature is enabled through 
        * the Code Generation settings)
*/
static void MX_GPIO_Init(void)
{

  GPIO_InitTypeDef GPIO_InitStruct;

  /* GPIO Ports Clock Enable */
  __HAL_RCC_GPIOC_CLK_ENABLE();
  __HAL_RCC_GPIOA_CLK_ENABLE();
  __HAL_RCC_GPIOB_CLK_ENABLE();

  /*Configure GPIO pin Output Level */
  HAL_GPIO_WritePin(THERM_SW_GPIO_Port, THERM_SW_Pin, GPIO_PIN_RESET);

  /*Configure GPIO pin Output Level */
  HAL_GPIO_WritePin(LED_DBG_GPIO_Port, LED_DBG_Pin, GPIO_PIN_RESET);

  /*Configure GPIO pin : THERM_SW_Pin */
  GPIO_InitStruct.Pin = THERM_SW_Pin;
  GPIO_InitStruct.Mode = GPIO_MODE_OUTPUT_PP;
  GPIO_InitStruct.Pull = GPIO_NOPULL;
  GPIO_InitStruct.Speed = GPIO_SPEED_FREQ_LOW;
  HAL_GPIO_Init(THERM_SW_GPIO_Port, &GPIO_InitStruct);

  /*Configure GPIO pin : PC15 */
  GPIO_InitStruct.Pin = GPIO_PIN_15;
  GPIO_InitStruct.Mode = GPIO_MODE_ANALOG;
  GPIO_InitStruct.Pull = GPIO_NOPULL;
  HAL_GPIO_Init(GPIOC, &GPIO_InitStruct);

  /*Configure GPIO pins : PA4 PA5 PA6 PA7 
                           PA8 PA9 PA10 PA11 
                           PA12 */
  GPIO_InitStruct.Pin = GPIO_PIN_4|GPIO_PIN_5|GPIO_PIN_6|GPIO_PIN_7 
                          |GPIO_PIN_8|GPIO_PIN_9|GPIO_PIN_10|GPIO_PIN_11 
                          |GPIO_PIN_12;
  GPIO_InitStruct.Mode = GPIO_MODE_ANALOG;
  GPIO_InitStruct.Pull = GPIO_NOPULL;
  HAL_GPIO_Init(GPIOA, &GPIO_InitStruct);

  /*Configure GPIO pins : PB0 BATT_2_Pin PB3 PB4 
                           PB5 */
  GPIO_InitStruct.Pin = GPIO_PIN_0|BATT_2_Pin|GPIO_PIN_3|GPIO_PIN_4 
                          |GPIO_PIN_5;
  GPIO_InitStruct.Mode = GPIO_MODE_ANALOG;
  GPIO_InitStruct.Pull = GPIO_NOPULL;
  HAL_GPIO_Init(GPIOB, &GPIO_InitStruct);

  /*Configure GPIO pin : LED_DBG_Pin */
  GPIO_InitStruct.Pin = LED_DBG_Pin;
  GPIO_InitStruct.Mode = GPIO_MODE_OUTPUT_PP;
  GPIO_InitStruct.Pull = GPIO_NOPULL;
  GPIO_InitStruct.Speed = GPIO_SPEED_FREQ_LOW;
  HAL_GPIO_Init(LED_DBG_GPIO_Port, &GPIO_InitStruct);

}

/* WatchdogTask function */
void WatchdogTask(void const * argument)
{

  /* USER CODE BEGIN 5 */
	(void)argument;
	while(1)
	{
		// Delay first to avoid triggering window after boot.
		osDelay(2000);
		HAL_IWDG_Refresh(&hiwdg);
	}
  /* USER CODE END 5 */ 
}

/**
  * @brief  Period elapsed callback in non blocking mode
  * @note   This function is called  when TIM6 interrupt took place, inside
  * HAL_TIM_IRQHandler(). It makes a direct call to HAL_IncTick() to increment
  * a global variable "uwTick" used as application time base.
  * @param  htim : TIM handle
  * @retval None
  */
void HAL_TIM_PeriodElapsedCallback(TIM_HandleTypeDef *htim)
{
  if (htim->Instance == TIM6) {
    HAL_IncTick();
  }
}

/**
  * @brief  This function is executed in case of error occurrence.
  * @param  None
  * @retval None
  */
void Error_Handler(void)
{
  /* USER CODE BEGIN Error_Handler */
	HAL_GPIO_WritePin(LED_DBG_GPIO_Port, LED_DBG_Pin, GPIO_PIN_SET);
	osThreadSuspendAll();
	while(1)
	{
	}
  /* USER CODE END Error_Handler */ 
}

#ifdef USE_FULL_ASSERT

/**
   * @brief Reports the name of the source file and the source line number
   * where the assert_param error has occurred.
   * @param file: pointer to the source file name
   * @param line: assert_param error line source number
   * @retval None
   */
void assert_failed(uint8_t* file, uint32_t line)
{
  /* USER CODE BEGIN 6 */
  /* User can add his own implementation to report the file name and line number,
    ex: printf("Wrong parameters value: file %s on line %d\r\n", file, line) */
  /* USER CODE END 6 */

}

#endif

/**
  * @}
  */ 

/**
  * @}
*/ 

/************************ (C) COPYRIGHT STMicroelectronics *****END OF FILE****/
