ravotus/FaucetLED/FaucetLED/FaucetLED.ioc

Mcu.UserName=STM32L052K8Tx
PA0.GPIO_Label=LED_R
PA0.Signal=S_TIM2_CH1
PA1.GPIO_Label=LED_G
PA1.Signal=S_TIM2_CH2
PA13.Signal=SYS_SWDIO
PA14.Signal=SYS_SWCLK
PA15.GPIO_Label=LED_DBG
PA15.Signal=GPIO_Output
PA2.GPIO_Label=LED_B
PA2.Signal=S_TIM2_CH3
PA3.GPIO_Label=THERM_SENSE
PA3.Signal=ADC_IN3
PB1.GPIO_Label=BATT_2
PB1.Signal=GPIO_Analog
PB6.GPIO_Label=TSC_SAMPLING
PB6.Signal=TSC_G5_IO3
PB7.GPIO_Label=TSC_IN
PB7.Signal=TSC_G5_IO4
PC14-OSC32_IN.GPIO_Label=THERM_SW
PC14-OSC32_IN.Signal=GPIO_Output
