ravotus/FaucetLED/(commit log)

2016-11-12 Add base project generated by STM32CubeMX 1.17
2016-11-12 Add BSP support for Nucleo board
2016-11-12 Change default task to LED toggle for demo
2016-11-13 First testing: ADC updates, use opamp with external gain
    ADC regular channel for piezo sensor, and injected channel for VREFINT.
    This allows each to be triggered individually. Also configure opamp
    for external gain (since PGA16 didn't seem to be enough).
    Set LED when small shock detected.
    [FaucetLED.ioc, main.c]
2016-11-20 Added driver for tri-color LED with TIM1 PWM
2016-11-20 Add debug configuration files
    [.custom.cfg, FaucetLED.cfg]
2016-11-20 Set all unused pins as analog for power savings
2016-11-20 Remove ADC test reading code from LED task
2016-11-27 DS18B20: Enable crude reading of temperatures
2016-11-27 Add FreeRTOS task-aware debug support
    [FaucetLED.cfg, FaucetLED_FreeRTOS.cfg]
2016-11-27 led: Clean up enum comment
2016-11-30 DS18B20: Enable DMA transactions
2016-12-03 ds18b20: Clean up driver and add command structs
2016-12-06 adc: Read charge amplifier at 5.2kHz and calc stddev
    Updated notes and such with test results from fixed Vcc/2 reference
    buffer for the charge amplifier. Tested successfully on the sink.
    [FaucetLED.ioc, app.c, app.h, main.c, main.h]
2016-12-07 app: Add 5-sample debouncing for fewer false-positives
2016-12-07 app: Add comment about stdev calculation, fix some magic numbers
    [app.c, app.h]
2016-12-07 app: Basic LED scaling based on temperature (probe is slow)
2016-12-10 Read thermistor on ADC and convert to C
2016-12-10 Remove DS18B20 code and UART drivers
2016-12-10 Fix some ADC bugs found by removal of DS18B20 code
    [app.c]
2016-12-10 Update to STM32CubeMX 4.18.0
2016-12-15 adc: Right-align data to prevent issues with oversampling.
    [FaucetLED.ioc, app.c, main.c]
2016-12-15 led: Color fading on log scale.
2016-12-16 FreeRTOS: Tweak a couple config options
2016-12-16 Disable LSE oscillator since it's not needed
    [FaucetLED.ioc, main.c]
2016-12-17 Remove LED toggle task, make AdcReader the default
    Also workaround CubeMX issue where the default task can't be extern'd.
    [FaucetLED.ioc, main.c]
2016-12-17 FreeRTOS: Enable tickless idle, workaround pointer issue
    in configPRE_SLEEP_PROCESSING and post-processing macros.
    [FaucetLED.ioc]
2016-12-17 adc: Remove extra injectred channel in sequence configuration.
2016-12-17 led: Move LED control to TIM2
2016-12-17 No need to track .settings.settings.settings.
2016-12-18 hardware: Add notes about Vin on Nucleo board
2016-12-25 Lots of work in progress changes for low-power mode
    Restore regulator to normal mode when exiting sleep.
2016-12-26 Run MSI clk at 400kHz in tickless idle mode.
    Seems to be the sweet spot for current consumption with one 10ms task.
    However, more testing is needed with the real app.
2016-12-27 Revert STM32Cube project debug changes.
    [FaucetLED.ioc]
2017-01-10 Move thermistor input to PA6 - ADC channel 11.
2017-01-15 Low-power mode working. Run MSI at 48kHz, LPSleep at 400kHz.
2017-01-15 Use /16 divisor for APB1/2 clocks for power savings.
2017-01-15 opamp: Run in low-power mode to save power.
    The opamp is only used as a buffer for a resistive divider. Turning
    it off saved appromxiately 90uA.
2017-01-15 ADC: Power down while not in use.
2017-01-16 Shut down both internal and external opamps for power savings.
2017-01-21 Switch thermistor off via GPIO to decrease current consumption.
2017-01-21 app.h: Fix incorrect timer define.
    [app.h, main.c]
2017-01-21 LED timer: Adjust timer divisors for PWM frequency in full and low power.
2017-01-21 Add image of current consumption with thermistor switching.
2017-01-22 Low-power stop mode working when TIM2 not needed.
    Still need to figure out why the current is higher if the TIM2 GPIO are
    configured.
2017-01-22 led: Set GPIO to analog when disabled to avoid extra current draw.
    [app.c, led.c, main.c]
2017-01-22 app: Delay after disabling thermistor to allow transients to dissipate.
2017-01-22 app: Only take 64 samples to save power. Update notes.
2017-01-22 Go into LPSleep when LED is on, remove some debug code.
2017-01-25 Add pin labels for the remaining used pins.
2017-01-27 ADC: Increase Fsample to 9.87kHz.
2017-01-27 LED: Only update once per second to decrease flicker.
2017-01-29 App, ADC: Don't use any injected channels. Reorder conversions.
    Injected channels make it more difficult to port the code to the STM32L0.
    It doesn't make sense to read the thermistor if we aren't going to turn on
    the LED.
    [FaucetLED.ioc, app.c, app.h, main.c]
2017-01-29 App: Fix use of double-precision float constant.
    [app.c]
2017-01-29 App: Use average of samples to determine LED activation.
2017-01-29 App: Disable shutdown of opamp/Vcc_2 buf because it is causing problems.
    [app.c]
2017-02-01 App: Improve algorithm for detecting vibrations. No more averages.
    Averaging didn't go a good job of filtering out larger spikes in the
    input, such as if the piezo sensor was hit with a larger force.
    Go back to the older "at least n of m" approach.
    [app.c, app.h]
2017-02-01 Update to STM32CubeMX 4.19.0.
2017-02-05 Led: Move command handling into task, add fading.
2017-02-08 Don't track Eclipse .launch files.
2017-02-10 Enable link-time optimization on release build.
    This option saves significantly on code size (~5k currently).
    Several functions called only from within assembly caused
    undefined reference errors. These had to be marked explicitly
    with __attribute__ ((used)).
2017-02-12 Add ARM DSP lib project.
2017-02-28 Migrate project to STM32L052.
2017-03-01 Fix a couple minor generation issues.
    [app.c, main.c]
2017-03-01 Remove old debug configurations.
    [FaucetLED.cfg, FaucetLED_FreeRTOS.cfg]
2017-03-03 Add ARM Cortex M0+ math project.
2017-03-03 Link with ARM math library in M0 project.
2017-03-03 ADC works and reads Vrefint/therm. Remove lots of old app code.
    Had to temporarily change ADC channels to test on the dev kit. Also
    had to disable TSC. Those changes were not committed.
2017-03-05 Lock all LED pins in STM32Cube.
2017-03-08 App: Workaround ADC errata 2.2.1 by reading twice.
    The ADC has an errata which can result in the converted value being
    incorrect if there is > 0.5ms since the last ADC conversion. The
    easiest way to work around this errata is just to read the ADC
    channel twice, using the second value.
    [app.c]
2017-03-11 freertos: Turn on LED on assert failure, add vAssertHook.
2017-03-11 Enable tickless idle, run Cortex timer at HCLK/8.
2017-03-12 resources: Add Fixed point reference and regulator datasheets.
2017-03-13 adc: Run at 4MHz. Don't use Vrefint since it's not needed.
    Also had issues in low-power regulator mode with low-frequency ADC,
    so just run at a slightly higher freq. instead.
    [FaucetLED.ioc, app.c, main.c]
2017-03-14 Use 3rd order polynomial fit for thermistor calc.
2017-03-14 app: Improve LED fading algorithm.
2017-03-14 app/led: Simplify fading algorithm.
2017-03-16 app/led: Improve fading by not updating excessively.
2017-03-20 Remove dead code related to low-power sleep.
2017-03-20 main.c: Remove freeze of IWDG in debug since it doesn't seem to work.
    [main.c]
2017-04-02 app: Used signed int for temperature.
2017-04-13 app: Change water threshold to 20% capacitance decrease.
2017-05-03 app.c: Add LED override to prevent the LED from being on too long.
    [app.c, app.h]
